joshuawboone/barkitup/README.md

# barkitup
Bark It Up! Fursuits and Rave Gear - ZettaLights dev repo  

LICENSING  
  
All board ref designs follow the same Creative Commons Attribution-ShareAlike 3.0 Unported licensing as the reference boards and stored in the PCB directory directly.  
  
All Code throughout the repo follows the license located at /zettalights/Code/ even if not in this directory. MIT Licensing.  
  
All other designs, STLs, SCAD, and anything else not licensed by the above 2 licenses follows CC BY-NC-SA 4.0 stored at /zettalights/archive/ as well as the respective sub-directories for each project.  
  
Contact support@barkitup.dog for commercial licensing inquiries.  

# You can help support me at https://ko-fi.com/barkitup  

# <3  
# -Z
