joshuawboone/barkitup/zettalights/readme.md

ZettaLights - PCB repo and designs
Bootloader file for PCB and notes on uploading files.

# You can help support me at https://ko-fi.com/barkitup 

# <3
# -Z

Custom wearable Rave Gear.
https://bsky.app/profile/barkitup.dog/post/3lxjax64se22s

https://bsky.app/profile/barkitup.dog/post/3lxr5w2wdyk2l

https://bsky.app/profile/barkitup.dog/post/3lxjed3b53s2s





Based on Adafruit Gemma M0, MAX4466, and Micro-Lipo USB-C designs
Copyright (c) 2017 Adafruit Industries
https://github.com/adafruit/Adafruit-Gemma-M0-PCB
https://github.com/adafruit/Adafruit-MAX4466-Electret-Mic-Amplifier-PCBs
https://github.com/adafruit/Adafruit-MicroLipo-PCB

Modifications Copyright (c) 2025 Joshua (Zettabit Fox) Boone 

LICENSING
All board ref designs follow the same Creative Commons Attribution-ShareAlike 3.0 Unported licensing as the reference boards. 

All Code throughout the repo follows the license located at /zettalights/Code/ even if not in this directory. MIT Licensing.  

All other designs, STLs, SCAD, and anything else not licensed by the above 2 licenses follows CC BY-NC-SA 4.0 stored at /zettalights/archive/ as well as the respective sub-directories for each project. 

Contact support@barkitup.dog for commercial licensing inquiries.
