joshuawboone/barkitup/zettalights/Code/readme.txt

# This is the core directory for the code releases. 

# Note the file name will have the number of LEDs in the series runs. 
# Note some code may be leftover or redundant from the AVR -> ARM conversion process. 
# I'll probably clean it up eventually ... ;3c

# See code directly for comments and user editable variables. 

# You can help support me at https://ko-fi.com/barkitup 

# Code is released under MIT licensing. 

# <3
# -Z
