joshuawboone/barkitup/zettalights/bootloader/readme.txt

# Bootloader v0.1 contains generic USB VID/PID while attempting to get assigned PID. 
# Bootloader v1_2505 contains USB VID/PID for requested 2505 PID on 1209 VID via pid.codes. 

# Build of bootloader was accomplished with the uf2-samdx1 repo and WSL on Windows 11. https://github.com/microsoft/uf2-samdx1.

# Programming of the bootloader was accoplished via OpenOCD and a STM32 ST-Link programmer using PowerShell and Putty.

# Bootloader notes: 
# Modified for SAMD21x17 lower memory map. 

# Command Notes: 

# C:\openocd\OpenOCD-20250710-0.12.0\bin\openocd.exe -f C:\openocd\OpenOCD-20250710-0.12.0\share\openocd\scripts\board\samd21.cfg
# PUTTY > localhost:4444
# halt
# flash write_image erase C:\\openocd\\bootloader-zlcustom-v1_2505.bin 0x0000

# Double tap reset button > should show ZETTALIGHTS USB disk for UF2 uploads. 

# Arduino IDE notes:

# Getting the board definition working involved modifications to the existing Adafruit board definitions by adding a custom board. 

# Included full modified boards.txt and required variant folder(s) to select the board in Arduino IDE. %localappdata%\Arduino15\packages\adafruit\hardware\samd\1.7.16\

# Currently only supports UF2 upload. Export Sketch to BIN, convert to UF2 via python script, drag and drop to board in bootloader mode. 
# python uf2conv.py -c -f 0x68ed2b88 -b 0x2000 sketch_sep7a.ino.bin -o test2.uf2

# Testing to get the board supported directly in IDE requires modifications to the base BOSSAC version and ran into numerous issues. Still testing.
