joshuawboone/barkitup/zettalights/ZL_C-TH_v1/readme.md

PCB designed via EasyEDA. 

Export files are in the EasyEDA .epro format. 

Gerber, BOM, and Pick-and-place files are standard format for use at any manufacturer. 
