joshuawboone/barkitup/zettalights/ZL_C-TH_v1/Enclosure/readme.txt

# Enclosure 3D files. requires 2x lids, 1x box, and 1x switch thing if desired.
