joshuawboone/barkitup/zettalights/Saber/photos/photo_8_2026-06-17_00-31-32.jpg

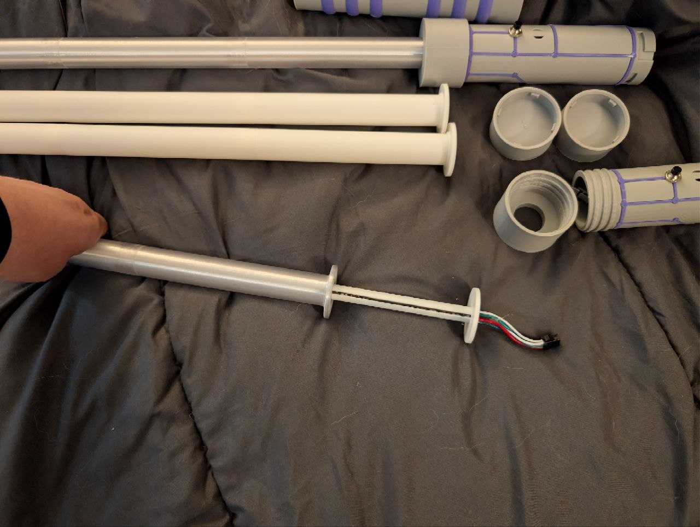
zettalights/Saber/photos/photo_8_2026-06-17_00-31-32.jpg
