joshuawboone/barkitup/zettalights/ZL_C-TH_v1/BOM_ZL_C-TH_v1.xlsx

No. | Quantity | Comment | Designator | Footprint | Value | Manufacturer Part | Manufacturer | Supplier Part | Supplier
1 | 1 | BH-18650-1 | BT1 | BAT-TH_BH-18650-A1AJ005 |  | BH-18650-1 | HanElectricity(瀚源) | C49118395 | LCSC
2 | 5 | 10uF | C1,C5,C6,C7,C8 | C0805 | 10uF | CL21A106KOQNNNE | SAMSUNG(三星) | C1713 | LCSC
3 | 1 | 100nF | C2 | C0603 | 100nF | CC0603KRX7R9BB104 | YAGEO(国巨) | C14663 | LCSC
4 | 1 | 10nF | C3 | C0603 | 10nF | CL10B103KB8NNNC | SAMSUNG(三星) | C1589 | LCSC
5 | 1 | 100pF | C4 | C0603 | 100pF | CL10C101JB8NNNC | SAMSUNG(三星) | C14858 | LCSC
6 | 1 | 1uF | C9 | C0805 | 1uF | 0805B105K500NT | FH(风华) | C215803 | LCSC
7 | 1 | 1uF | C10 | C0603 | 1uF | CL10A105KB8NNNC | SAMSUNG(三星) | C15849 | LCSC
8 | 2 | SS54 | D1,D2 | SMA_L4.4-W2.8-LS5.4-R-RD |  | SS54 | MDD(辰达半导体) | C22452 | LCSC
9 | 2 | SWD1 | GND,SWD | CON_PAD_ROUND_1.02MM
10 | 1 | 2-Pin | JP2 | HDR-TH_2P-P2.54-V-M-2
11 | 1 | 3-Pin | JP3 | HDR-TH_3P-P2.54-V-F_MF254V-11-03-0743
12 | 2 | BLM21PG221SN1D | L1,L2 | L0805 |  | BLM21PG221SN1D | muRata(村田) | C85840 | LCSC
13 | 1 | CHG Orange | LED1 | LED0805-RD_ORANGE |  | NCD0805O1 | 国星光电 | C84262 | LCSC
14 | 1 | PWR Red | LED2 | LED0805-R-RD |  | NCD0805R1 | 国星光电 | C84256 | LCSC
15 | 1 | CHGD Green | LED3 | LED0805-R-RD |  | NCD0805G1 | 国星光电 | C84260 | LCSC
16 | 1 | GMI9767P-60DB | MIC1 | MIC-TH_BD9.7-P2.54-D0.8-L-FD |  | GMI9767P-60DB | INGHAi(赢海) | C234027 | LCSC
17 | 1 | 100kΩ | R1 | RES-ADJ-SMD_3P-L4.5-W4.5-P2.30-BL-FS | 100kΩ | 3314J-1-104E | BOURNS | C51284 | LCSC
18 | 2 | 470Ω | R2,R3 | R0603 | 470Ω | 0603WAF4700T5E | UNI-ROYAL(厚声) | C23179 | LCSC
19 | 5 | 1kΩ | R4,R5,R6,R7,R8 | R0603 | 1kΩ | 0603WAF1001T5E | UNI-ROYAL(厚声) | C21190 | LCSC
20 | 2 | 1MΩ | R9,R10 | R0402 | 1MΩ | 0402WGF1004TCE | UNI-ROYAL(厚声) | C26083 | LCSC
21 | 1 | 22kΩ | R11 | R0402 | 22kΩ | 0402WGF2202TCE | UNI-ROYAL(厚声) | C25768 | LCSC
22 | 2 | 5.1kΩ | R12,R13 | R0603 | 5.1kΩ | 0603WAF5101T5E | UNI-ROYAL(厚声) | C23186 | LCSC
23 | 1 | TP1 | RST | CON_PAD_ROUND_1.02MM
24 | 1 | RST | SW1 | SW-SMD_L3.9-W3.0-P4.45 |  | TS-1088-AR02016 | XUNPU(讯普) | C720477 | LCSC
25 | 1 | SWC1 | SWC | CON_PAD_ROUND_1.02MM
26 | 1 | ATSAMD21E17A-AU | U1 | TQFP-32_L7.0-W7.0-P0.80-LS9.0-BL |  | ATSAMD21E17A-AU | MICROCHIP(美国微芯) | C1337408 | LCSC
27 | 1 | MAX4466EXK+T | U2 | SC-70-5_L2.0-W1.3-P0.65-LS2.1-BR |  | MAX4466EXK+T | ADI(亚德诺)/MAXIM(美信) | C7456762 | LCSC
28 | 1 | MCP73831T-2ACI/OT | U3 | SOT-23-5_L3.0-W1.7-P0.95-LS2.8-BL |  | MCP73831T-2ACI/OT | MICROCHIP(美国微芯) | C424093 | LCSC
29 | 1 | AP2112K-3.3TRG1 | U4 | SOT-25-5_L2.9-W1.6-P0.95-LS2.8-BL |  | AP2112K-3.3TRG1 | DIODES(美台) | C51118 | LCSC
30 | 1 | SW Power | U5 | SW-TH_SS-12M12G5 |  | SS-12M12G5 | XKB Connectivity(中国星坤) | C2884789 | LCSC
31 | 1 | USB4085-GF-A | USB2 | USC-C-SMD_USB4085-GF-A |  | USB4085-GF-A | GCT | C7095263 | LCSC
