joshuawboone/barkitup/zettalights/Saber/320-Saber-Full-Project.3mf

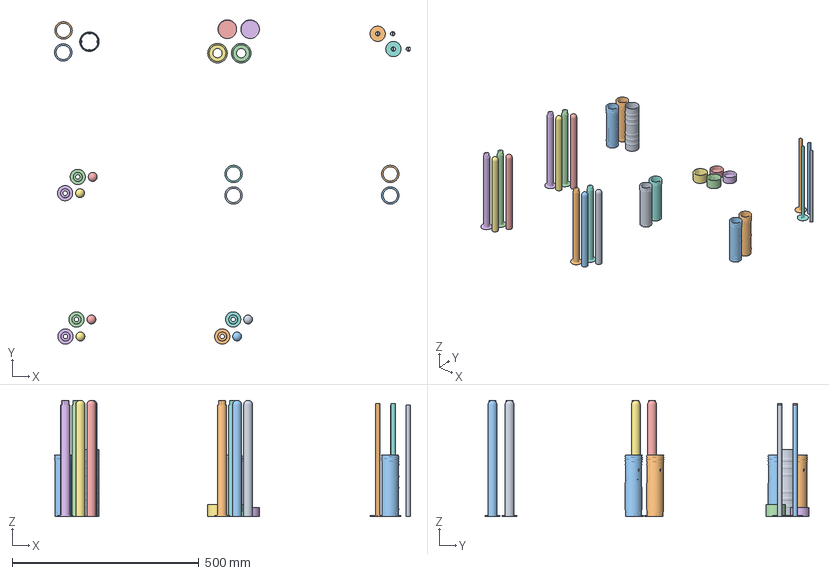
[picture p19: CAD file, 2026-08-04]
zettalights/Saber/320-Saber-Full-Project.3mf
954.1 x 869.1 x 312.0 mm
Coupler-plain
Handle-plain x 2
Cap-bladeSide.stl x 2
Cap-pommelSide.stl x 2
LED_seg1.stl x 2
LED_seg2.stl x 2
seg1.stl x 6
seg2.stl x 6
Handle-plain.stl x 2
Handle-oneColor.stl x 2
