joshuawboone/barkitup/zettalights/Staff/320/320-Staff-Full-Project.3mf

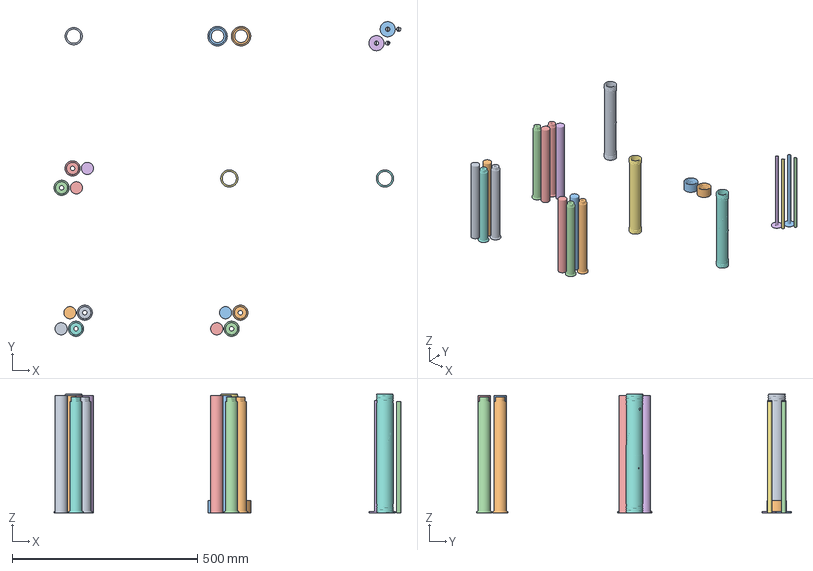
[picture p20: CAD file, 2026-08-04]
zettalights/Staff/320/320-Staff-Full-Project.3mf
936.6 x 849.5 x 320.0 mm
handle_plain
cap.stl x 2
LED-seg1.stl x 2
LED-seg2.stl x 2
seg1.stl x 6
seg2.stl x 6
handle_plain.stl
handle_traces.stl
