joshuawboone/barkitup/zettalights/Saber/Handle/handle-inserts-full.stl

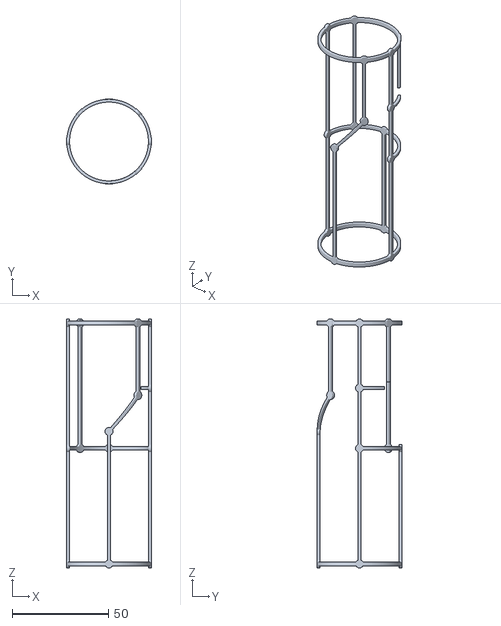
[picture p21: CAD file, 2026-06-17]
zettalights/Saber/Handle/handle-inserts-full.stl
44.2 x 44.2 x 129.6
