joshuawboone/barkitup/zettalights/Saber/v2_2-Full.3mf

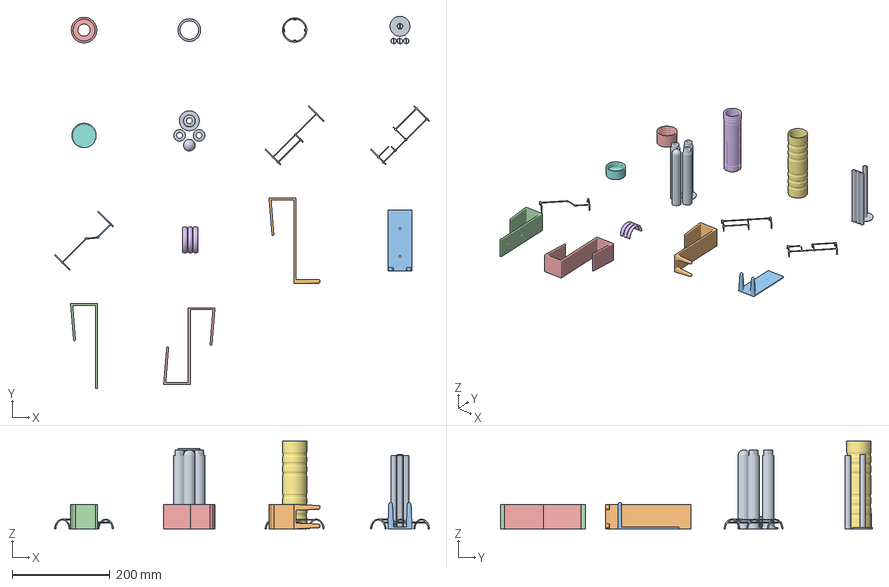
[picture p22: CAD file, 2026-06-17]
zettalights/Saber/v2_2-Full.3mf
769.2 x 763.8 x 180.0 mm
Assembly x 3
handle-insert-1.stl
handle-insert-3.stl
handle-insert-2.stl
open cap.stl
handle.stl
coupler.stl
closed cap.stl
saber_hanger.stl
saber_wall_fork.stl
saber_wall_hanger.stl
saber_doubleHook.stl
