joshuawboone/barkitup/zettalights/Saber/320/seg2.stl

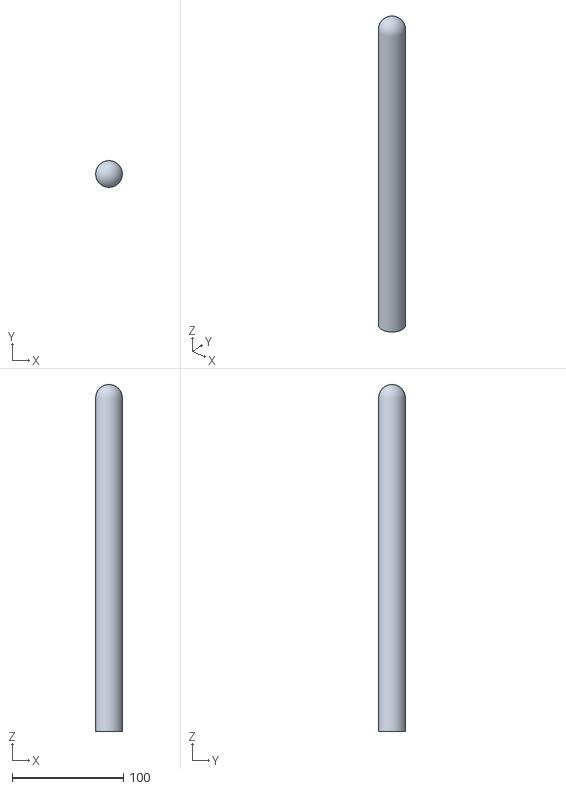
[picture p23: CAD file, 2026-08-04]
zettalights/Saber/320/seg2.stl
24.0 x 24.0 x 312.0
