joshuawboone/barkitup/zettalights/Saber/Blade/blade tip.stl

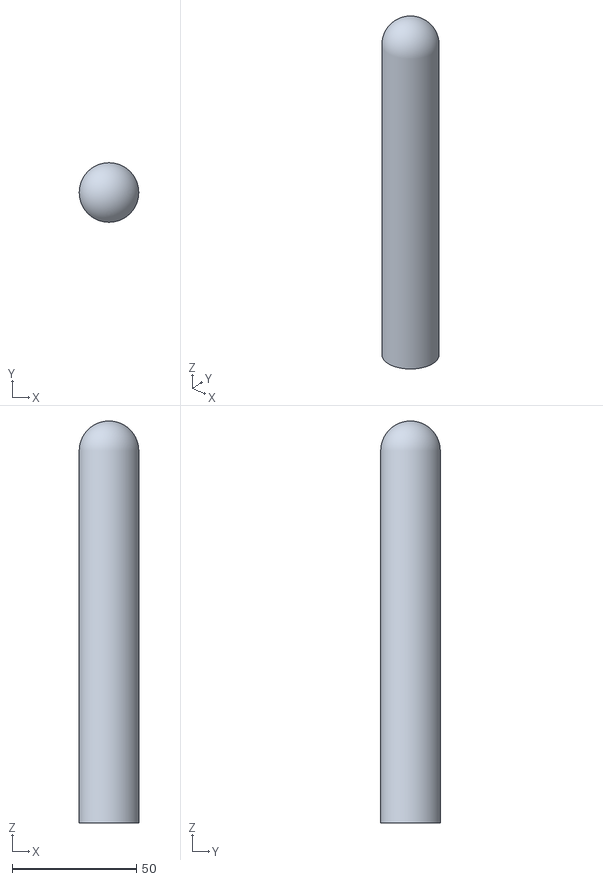
[picture p24: CAD file, 2026-06-17]
zettalights/Saber/Blade/blade tip.stl
24.0 x 24.0 x 162.0
