joshuawboone/barkitup/zettalights/Saber/Coupler-rings.stl

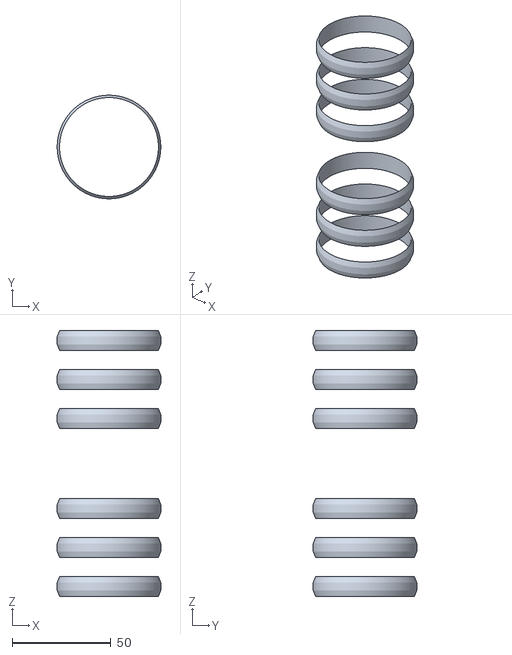
[picture p25: CAD file, 2026-08-04]
zettalights/Saber/Coupler-rings.stl
52.4 x 52.4 x 134.5
