joshuawboone/barkitup/zettalights/Saber/Handle/handle.stl

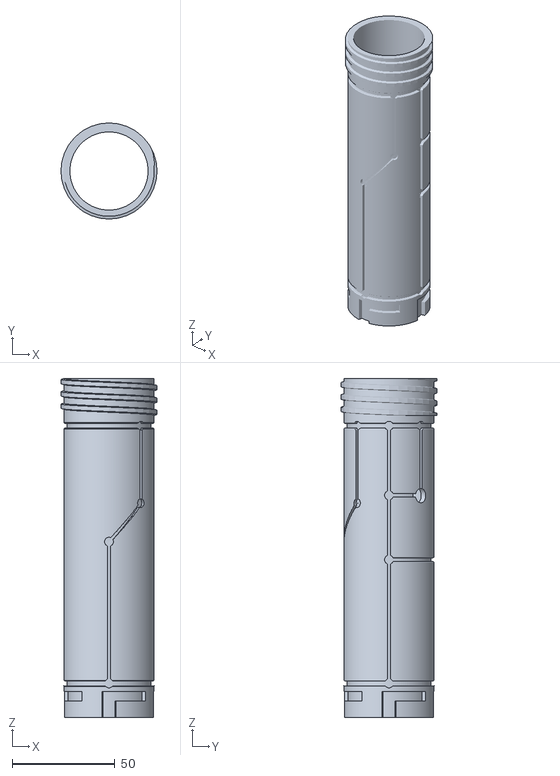
[picture p26: CAD file, 2026-06-17]
zettalights/Saber/Handle/handle.stl
46.8 x 46.8 x 165.0
