joshuawboone/barkitup/zettalights/Saber/Hangers/saber_hanger.stl

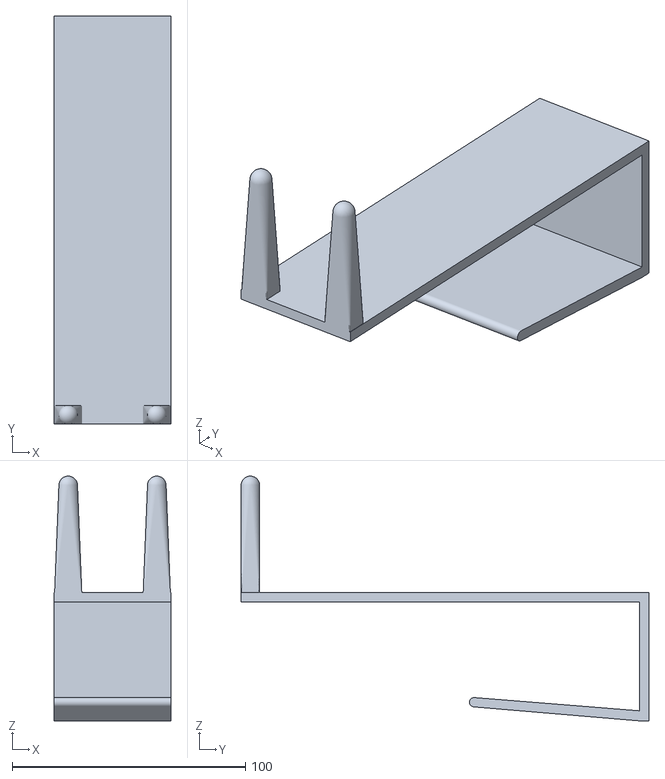
[picture p27: CAD file, 2026-06-17]
zettalights/Saber/Hangers/saber_hanger.stl
50.0 x 175.0 x 105.0
