joshuawboone/barkitup/zettalights/Staff/256/LEDinsert2-3.stl

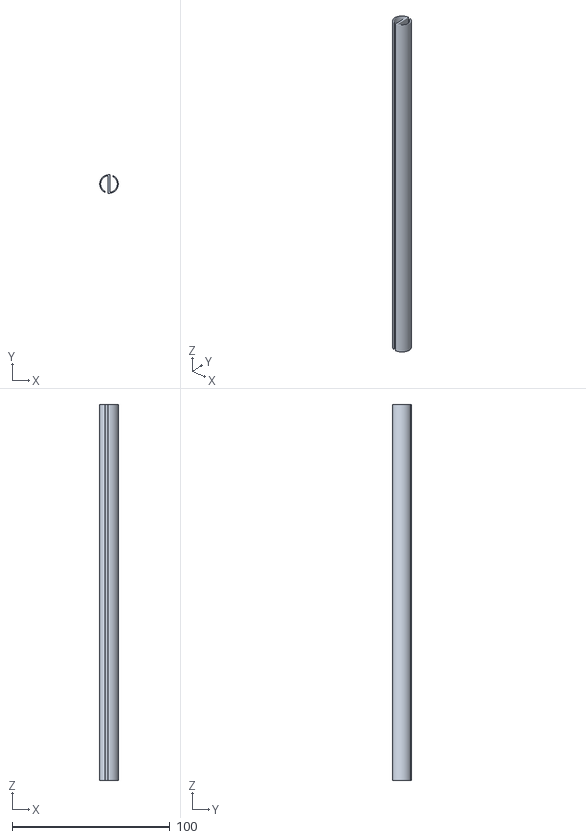
[picture p28: CAD file, 2026-07-16]
zettalights/Staff/256/LEDinsert2-3.stl
11.8 x 11.8 x 238.0
