joshuawboone/barkitup/zettalights/Staff/320/new_cap.stl

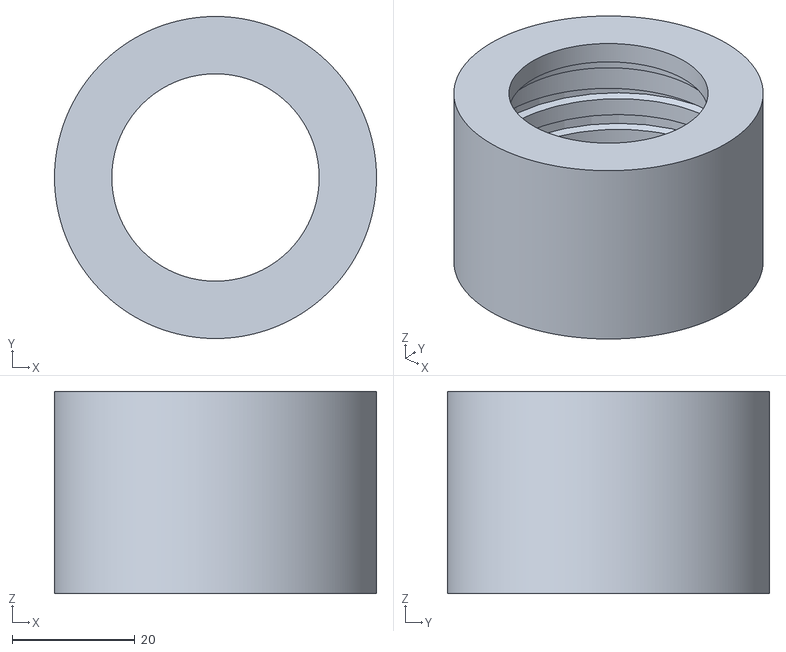
[picture p29: CAD file, 2026-10-22]
zettalights/Staff/320/new_cap.stl
52.5 x 52.5 x 33.0
