joshuawboone/barkitup/zettalights/Staff/340/LEDseg2.stl

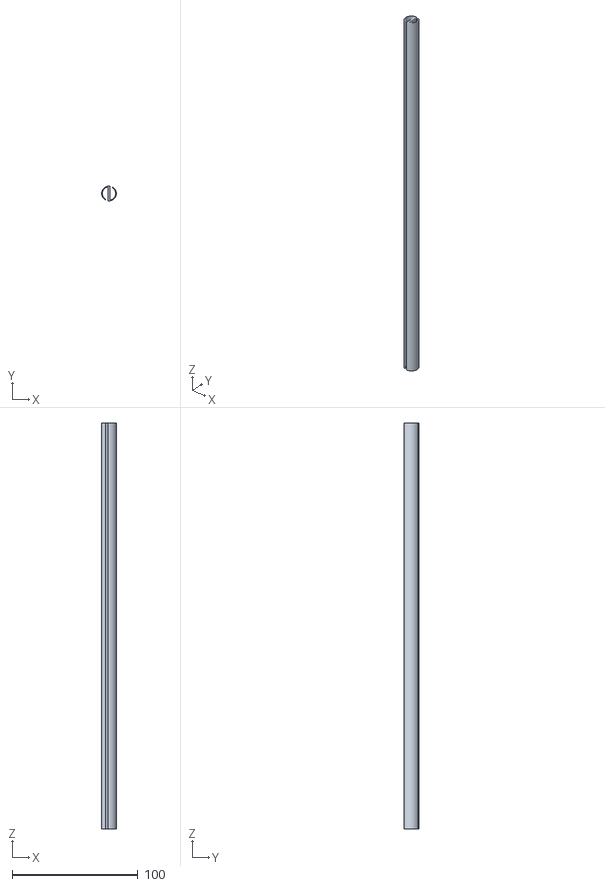
[picture p30: CAD file, 2026-07-16]
zettalights/Staff/340/LEDseg2.stl
11.8 x 11.8 x 323.0
