joshuawboone/barkitup/zettalights/Staff/seg1.stl

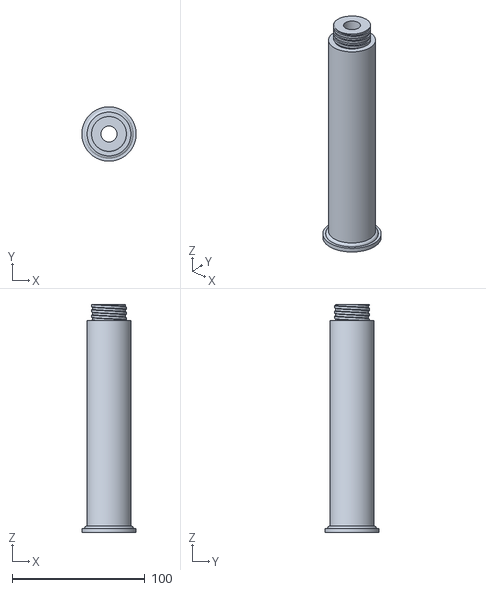
[picture p31: CAD file, 2026-07-16]
zettalights/Staff/seg1.stl
41.0 x 41.0 x 172.0
