joshuawboone/barkitup/zettalights/ZL_C-TH_v1/Enclosure/Lid-v4-testtabs.stl

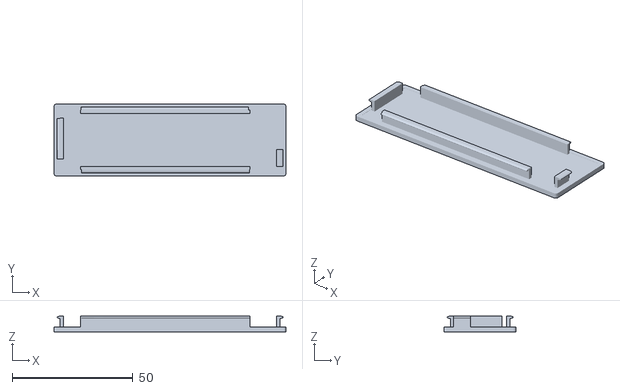
[picture p32: CAD file, 2025-10-22]
zettalights/ZL_C-TH_v1/Enclosure/Lid-v4-testtabs.stl
95.9 x 29.7 x 6.50
