joshuawboone/barkitup/zettalights/Saber/320/LED_seg1.stl

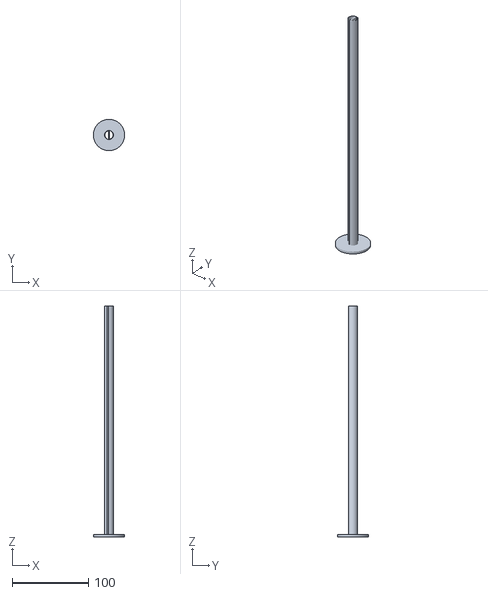
[picture p33: CAD file, 2026-08-04]
zettalights/Saber/320/LED_seg1.stl
41.0 x 41.0 x 303.0
