joshuawboone/barkitup/zettalights/Saber/Blade/blade base.stl

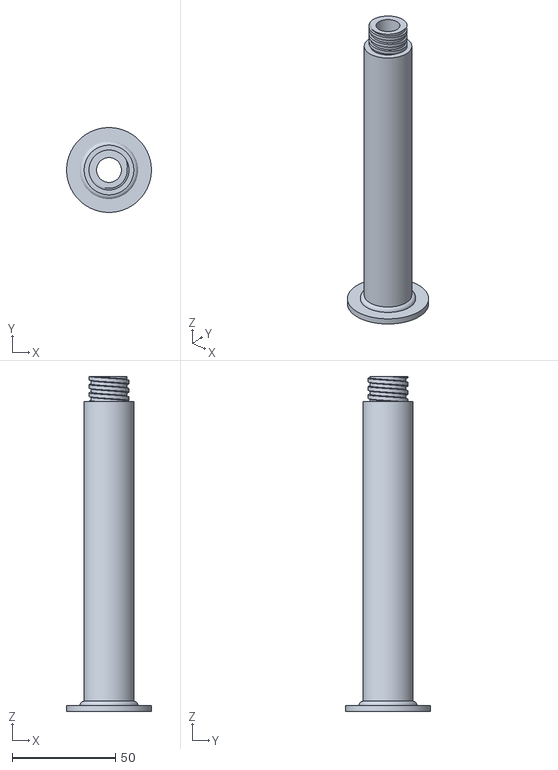
[picture p34: CAD file, 2026-06-17]
zettalights/Saber/Blade/blade base.stl
41.0 x 41.0 x 162.0
