joshuawboone/barkitup/zettalights/Saber/Cap-pommelSide.stl

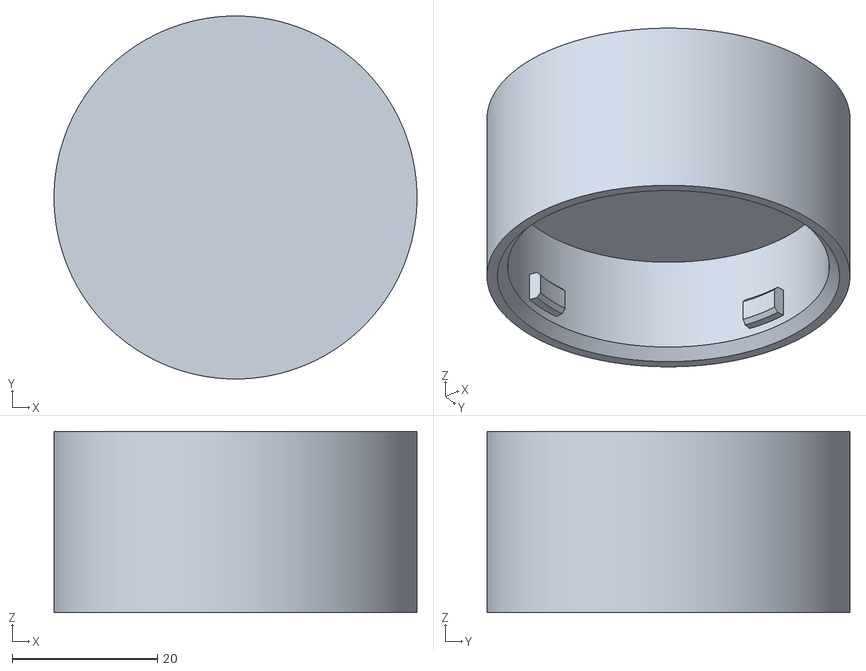
[picture p35: CAD file, 2026-08-04]
zettalights/Saber/Cap-pommelSide.stl
50.0 x 50.0 x 25.0
