joshuawboone/barkitup/zettalights/Saber/Handle/coupler.stl

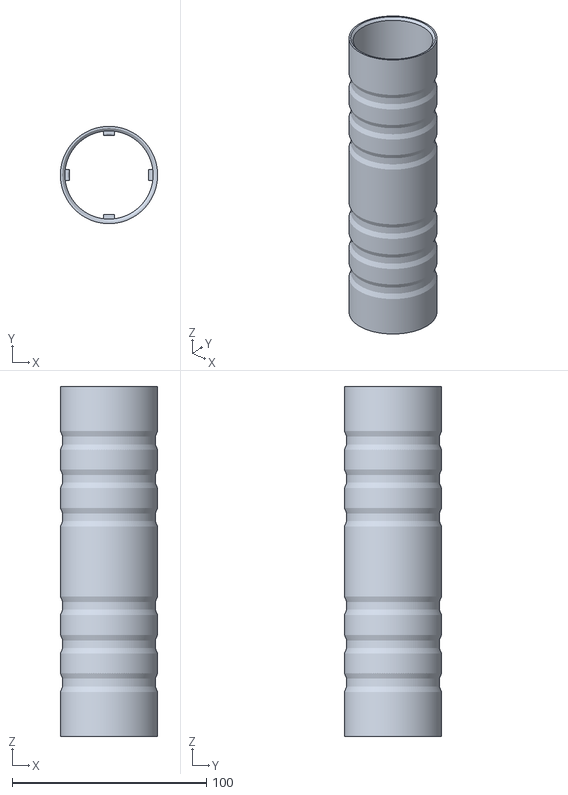
[picture p36: CAD file, 2026-06-17]
zettalights/Saber/Handle/coupler.stl
50.0 x 50.0 x 180.0
