joshuawboone/barkitup/zettalights/Saber/Hangers/saber_wall_fork.stl

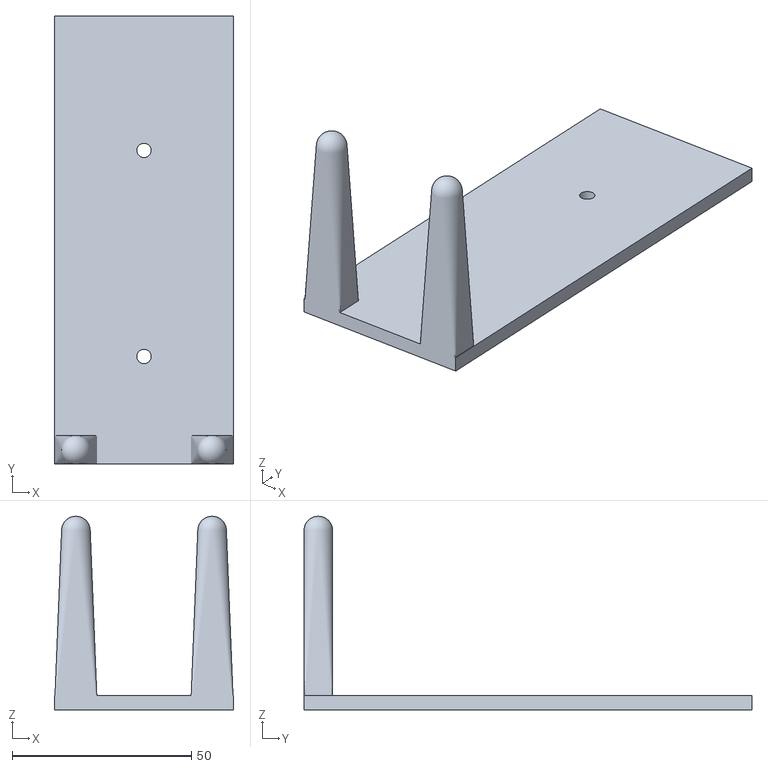
[picture p37: CAD file, 2026-06-17]
zettalights/Saber/Hangers/saber_wall_fork.stl
50.0 x 125.0 x 54.0
