joshuawboone/barkitup/zettalights/Staff/256/seg1.stl

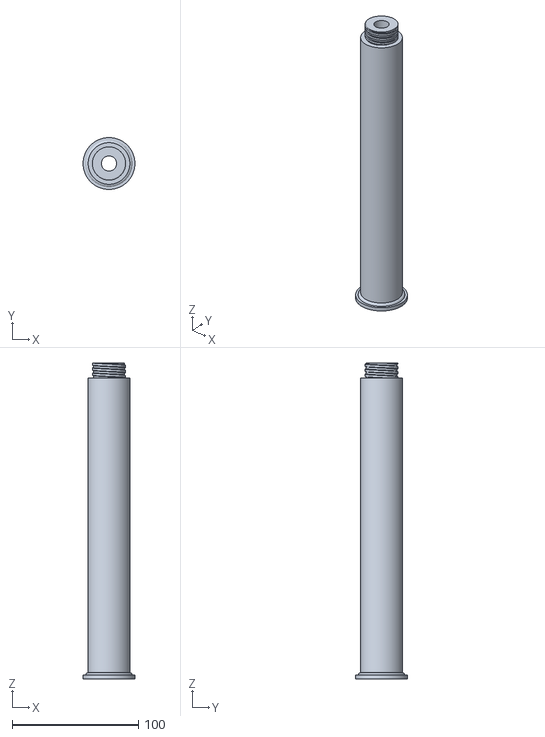
[picture p38: CAD file, 2026-07-16]
zettalights/Staff/256/seg1.stl
41.0 x 41.0 x 250.0
