joshuawboone/barkitup/zettalights/Staff/340/seg1.stl

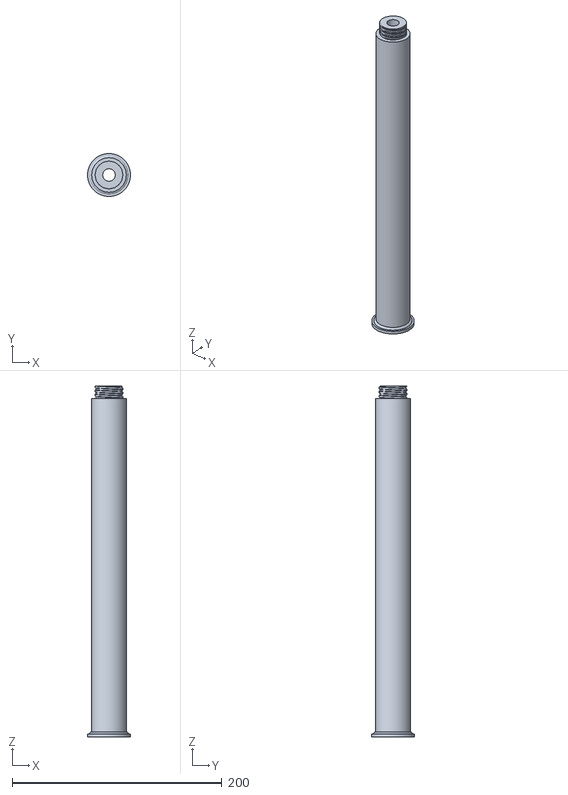
[picture p39: CAD file, 2026-07-16]
zettalights/Staff/340/seg1.stl
41.0 x 41.0 x 335.0
