joshuawboone/barkitup/zettalights/ZL_C-TH_v1/Enclosure/Box-v4-clip.stl

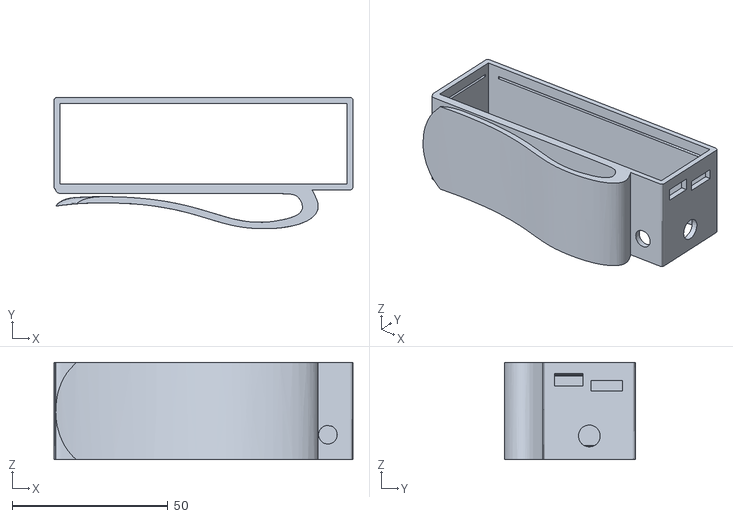
[picture p40: CAD file, 2025-10-22]
zettalights/ZL_C-TH_v1/Enclosure/Box-v4-clip.stl
95.9 x 42.1 x 31.2
