joshuawboone/barkitup/zettalights/Saber/320/seg1.stl

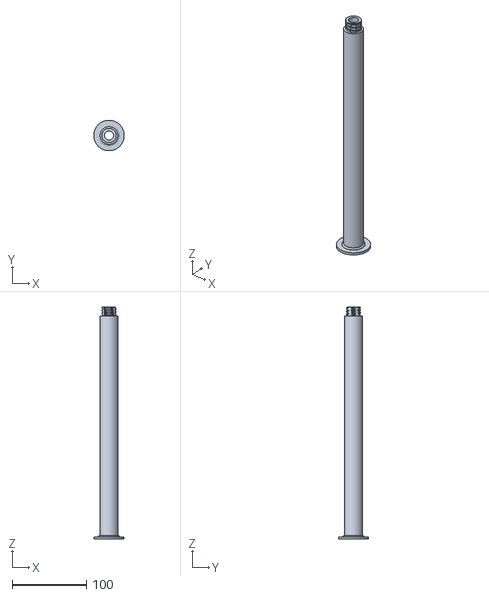
[picture p41: CAD file, 2026-08-04]
zettalights/Saber/320/seg1.stl
41.0 x 41.0 x 312.0
