joshuawboone/barkitup/zettalights/Saber/Coupler-oneColor.stl

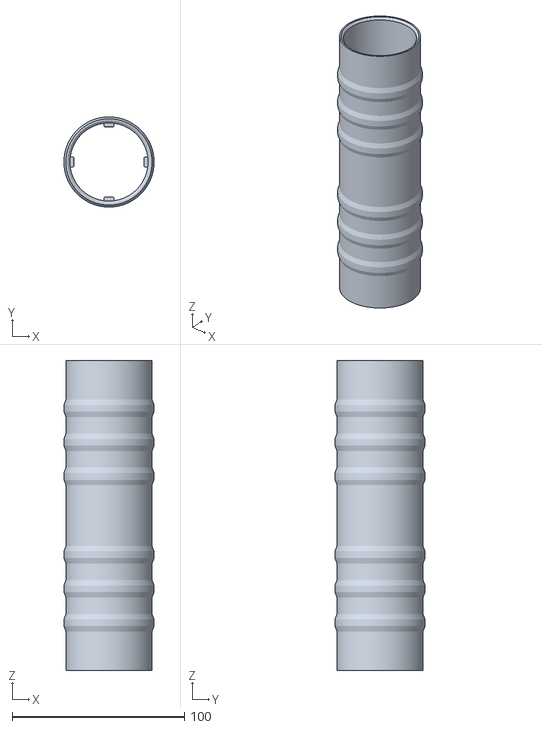
[picture p42: CAD file, 2026-08-04]
zettalights/Saber/Coupler-oneColor.stl
52.4 x 52.4 x 180.0
