joshuawboone/barkitup/zettalights/Saber/Handle/open cap.stl

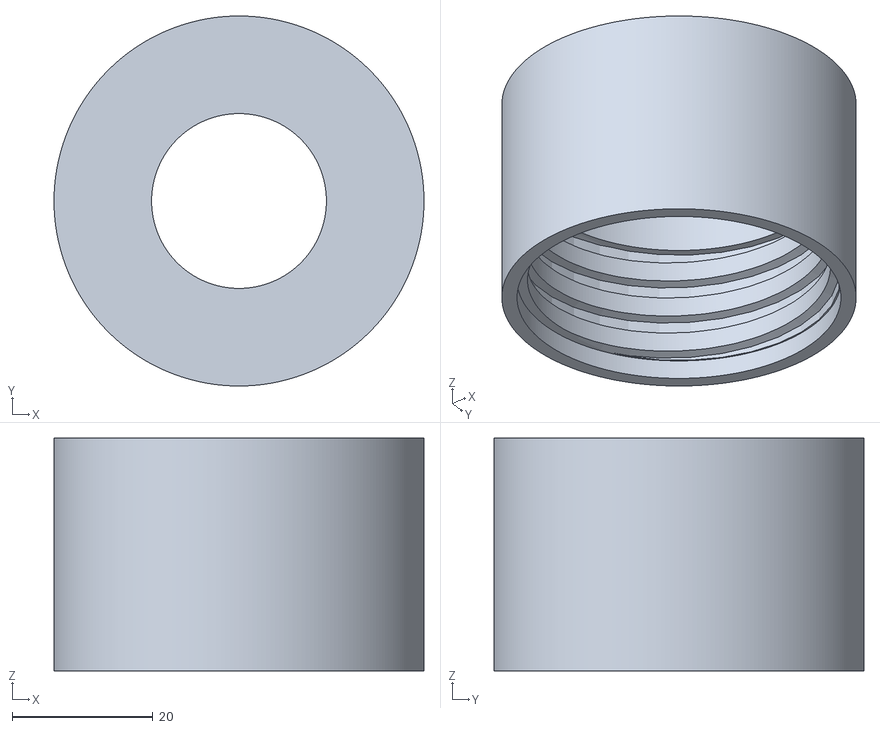
[picture p43: CAD file, 2026-06-17]
zettalights/Saber/Handle/open cap.stl
52.5 x 52.5 x 33.0
