joshuawboone/barkitup/zettalights/Saber/Hangers/wall-fork.stl

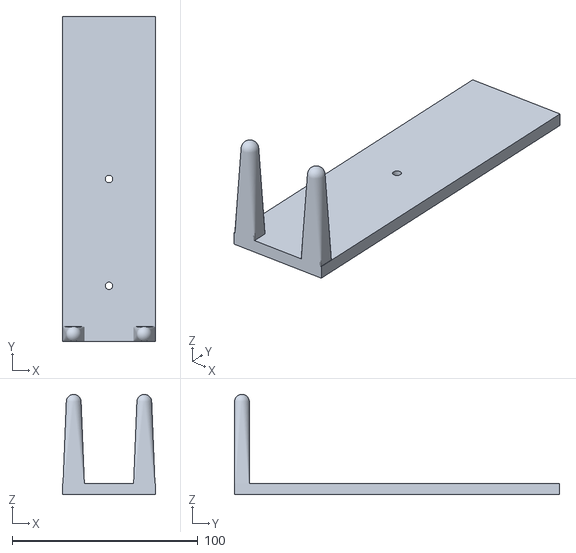
[picture p44: CAD file, 2026-06-17]
zettalights/Saber/Hangers/wall-fork.stl
50.0 x 175.0 x 54.0
