joshuawboone/barkitup/zettalights/Staff/256/LEDinsert1.stl

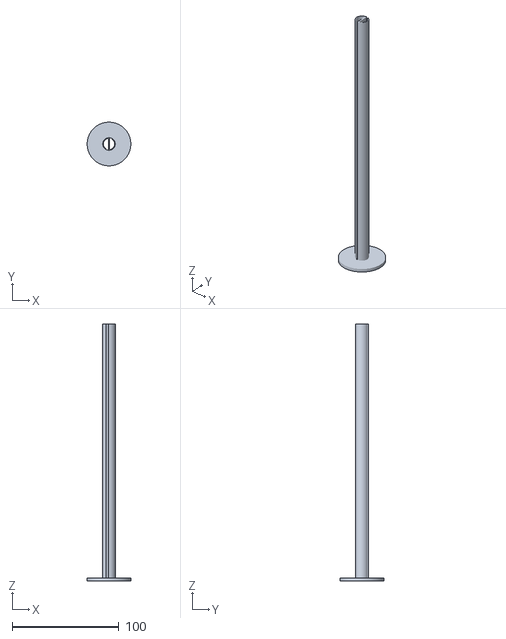
[picture p45: CAD file, 2026-07-16]
zettalights/Staff/256/LEDinsert1.stl
41.0 x 41.0 x 241.0
