joshuawboone/barkitup/zettalights/Staff/320/handle_traces.stl

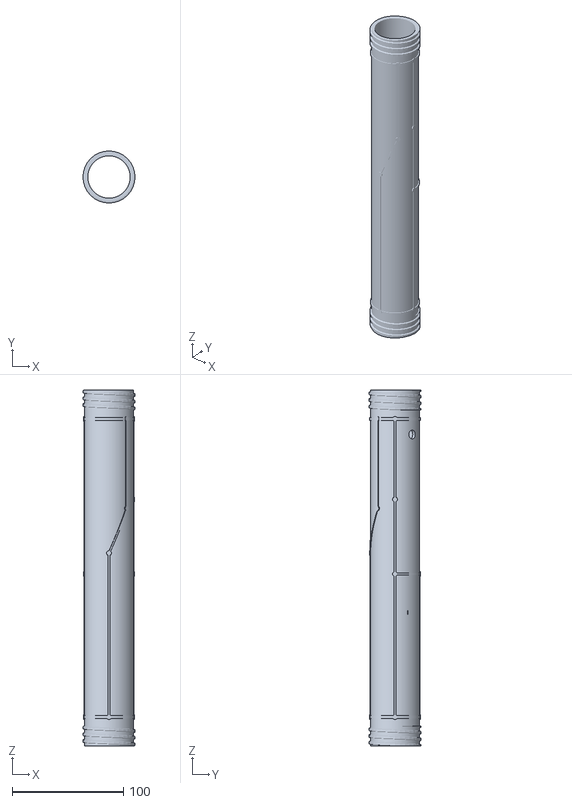
[picture p46: CAD file, 2026-08-04]
zettalights/Staff/320/handle_traces.stl
46.8 x 46.8 x 320.0
