joshuawboone/barkitup/zettalights/Staff/handle256.stl

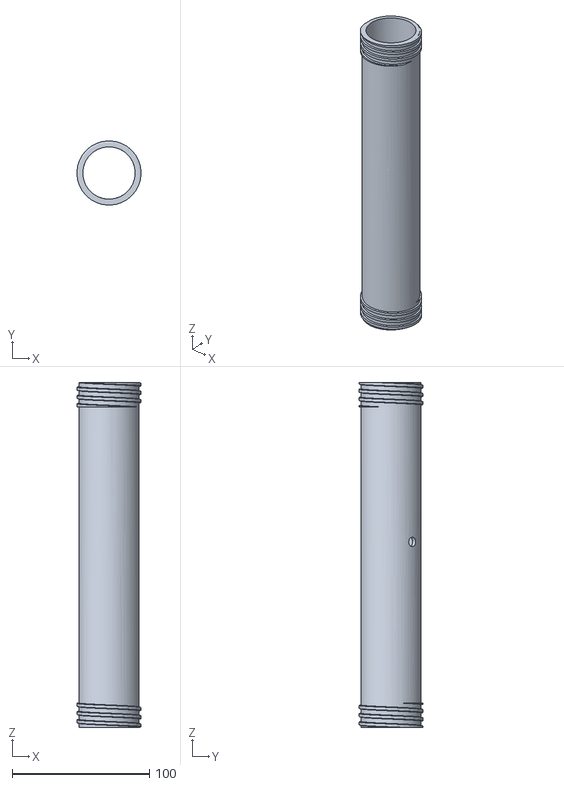
[picture p47: CAD file, 2026-07-16]
zettalights/Staff/handle256.stl
46.8 x 46.8 x 251.0
