joshuawboone/barkitup/zettalights/ZL_C-TH_v1/Enclosure/ButtonThing-v4.stl

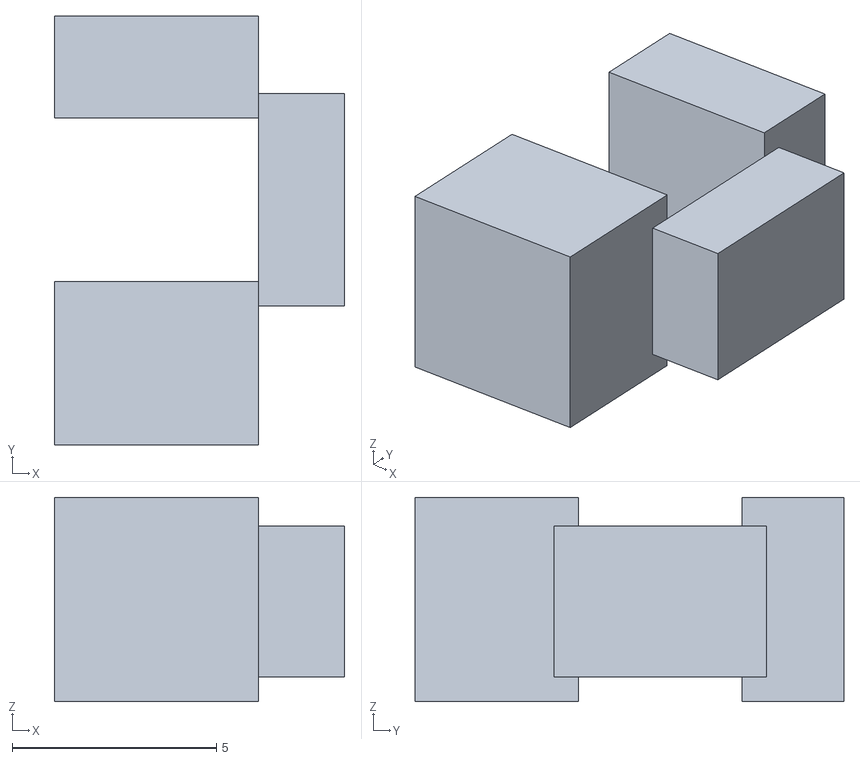
[picture p48: CAD file, 2025-10-22]
zettalights/ZL_C-TH_v1/Enclosure/ButtonThing-v4.stl
7.10 x 10.5 x 5.00
