joshuawboone/barkitup/zettalights/Saber/320/LED_seg2.stl

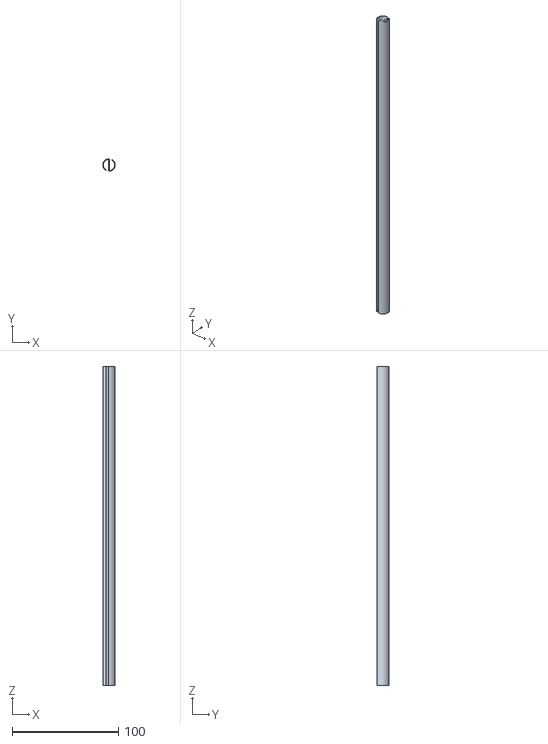
[picture p49: CAD file, 2026-07-16]
zettalights/Saber/320/LED_seg2.stl
11.8 x 11.8 x 300.0
