joshuawboone/barkitup/zettalights/Saber/Handle/handle-insert-3.stl

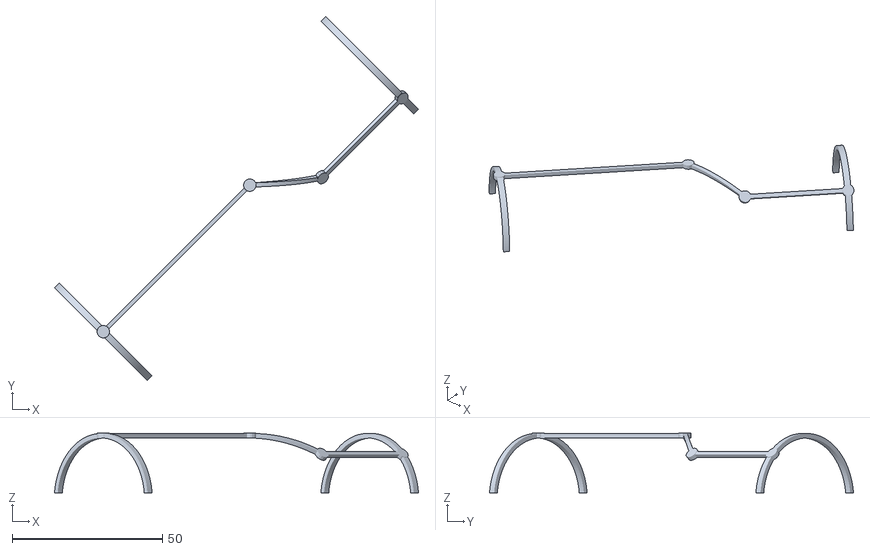
[picture p50: CAD file, 2026-06-17]
zettalights/Saber/Handle/handle-insert-3.stl
121.2 x 121.2 x 19.9
