joshuawboone/barkitup/zettalights/Saber/Hangers/cube-fork.stl

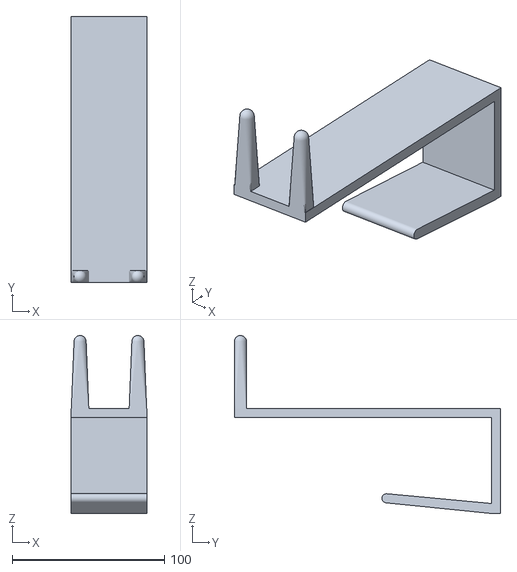
[picture p51: CAD file, 2026-06-17]
zettalights/Saber/Hangers/cube-fork.stl
50.0 x 175.0 x 117.0
