joshuawboone/barkitup/zettalights/Staff/256/seg2.stl

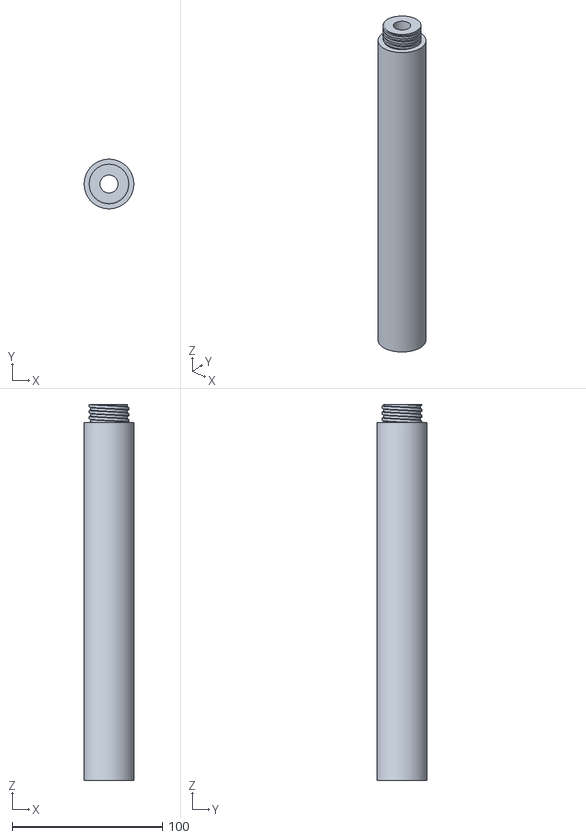
[picture p52: CAD file, 2026-07-16]
zettalights/Staff/256/seg2.stl
33.0 x 33.0 x 250.0
