joshuawboone/barkitup/zettalights/Staff/340/handle340.stl

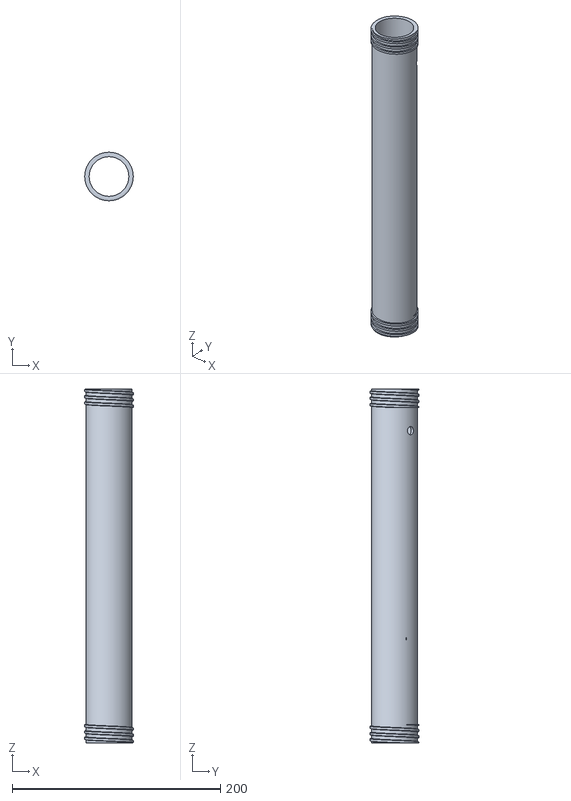
[picture p53: CAD file, 2026-07-16]
zettalights/Staff/340/handle340.stl
46.8 x 46.8 x 340.0
