joshuawboone/barkitup/zettalights/Staff/LED-seg1.stl

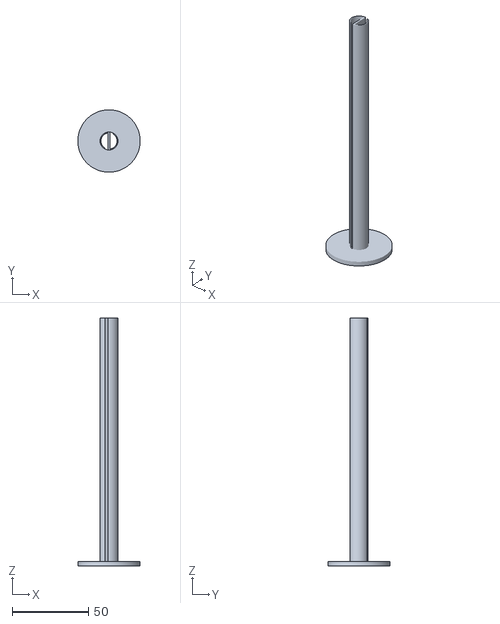
[picture p54: CAD file, 2026-07-16]
zettalights/Staff/LED-seg1.stl
41.0 x 41.0 x 163.0
