joshuawboone/barkitup/zettalights/Saber/Hangers/wall-hook.stl

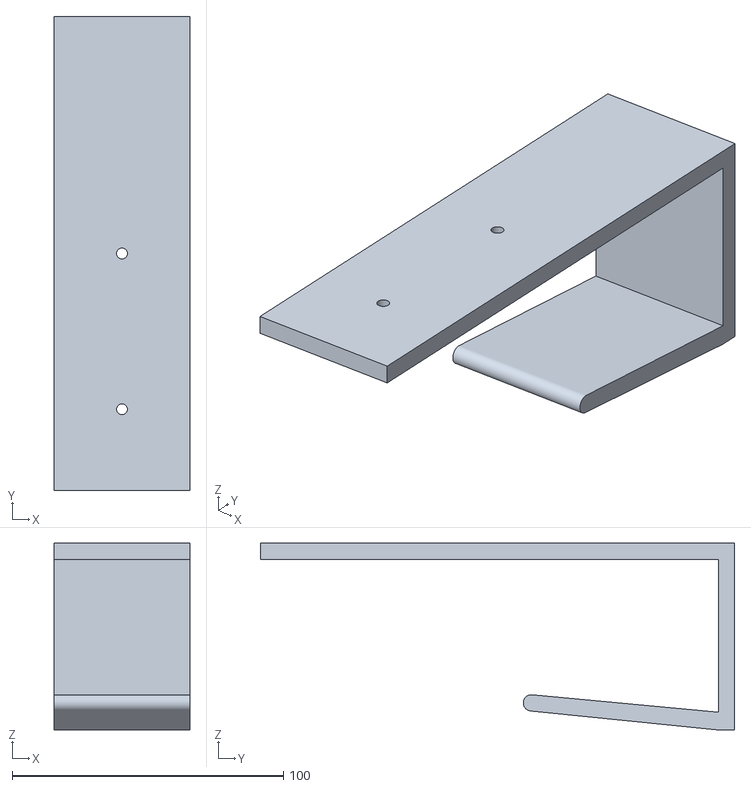
[picture p55: CAD file, 2026-06-17]
zettalights/Saber/Hangers/wall-hook.stl
50.0 x 175.0 x 69.0
