joshuawboone/barkitup/zettalights/Staff/340/LEDseg1.stl

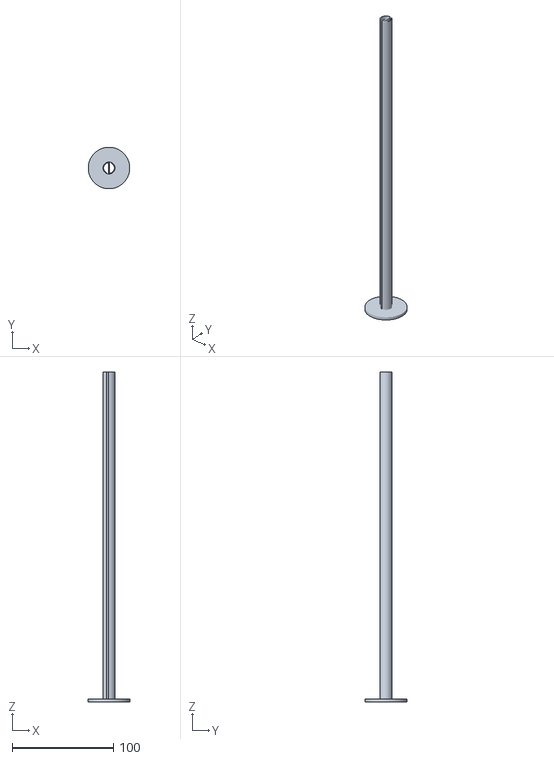
[picture p56: CAD file, 2026-07-16]
zettalights/Staff/340/LEDseg1.stl
41.0 x 41.0 x 326.0
