joshuawboone/barkitup/zettalights/Staff/seg2-3.stl

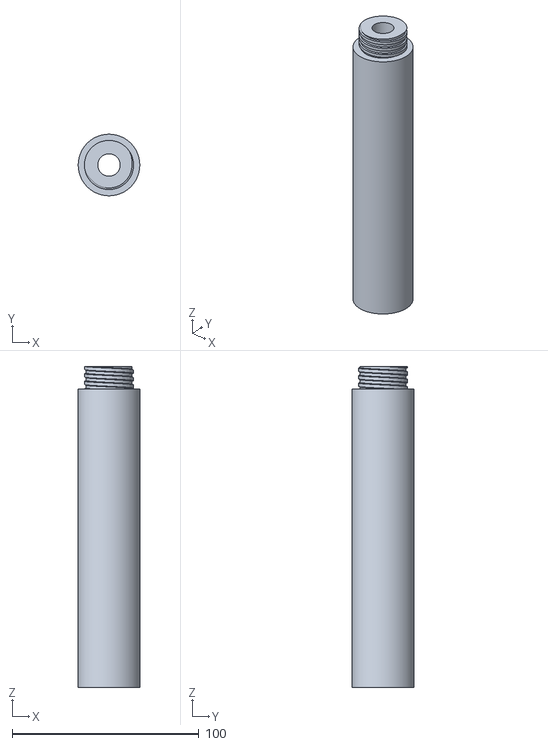
[picture p57: CAD file, 2026-07-16]
zettalights/Staff/seg2-3.stl
33.0 x 33.0 x 172.0
