joshuawboone/barkitup/zettalights/Saber/Blade/LEDseg234.stl

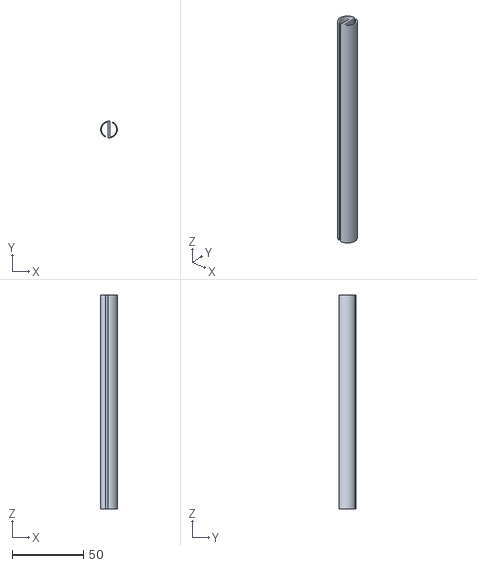
[picture p58: CAD file, 2026-06-17]
zettalights/Saber/Blade/LEDseg234.stl
11.8 x 11.8 x 150.0
