joshuawboone/barkitup/zettalights/Saber/Handle-plain.stl

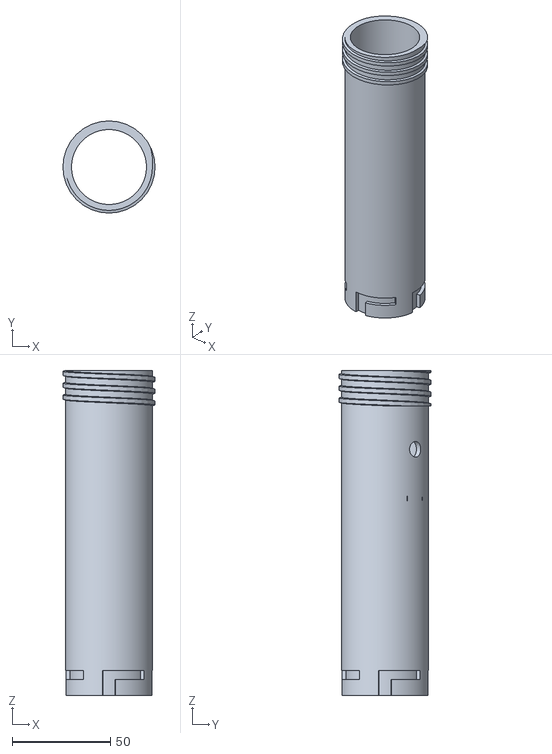
[picture p59: CAD file, 2026-08-04]
zettalights/Saber/Handle-plain.stl
46.8 x 46.8 x 165.0
