joshuawboone/barkitup/zettalights/Saber/Handle/coupler-insert.stl

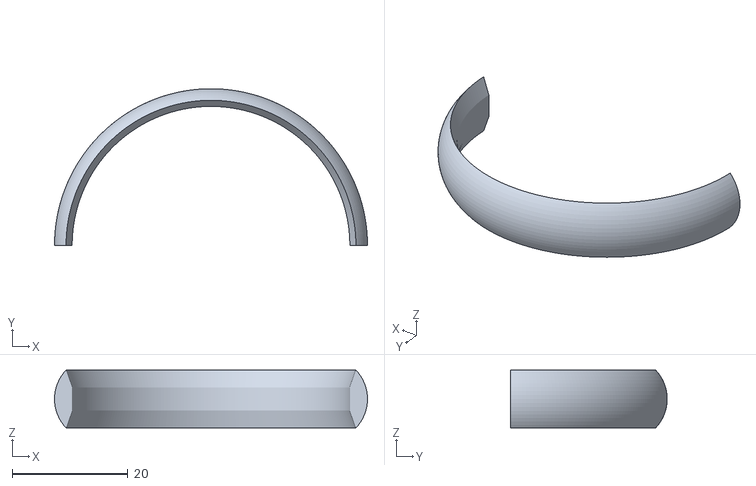
[picture p60: CAD file, 2026-06-17]
zettalights/Saber/Handle/coupler-insert.stl
54.0 x 27.0 x 10.0
