joshuawboone/barkitup/zettalights/Saber/Hangers/saber_wall_hanger.stl

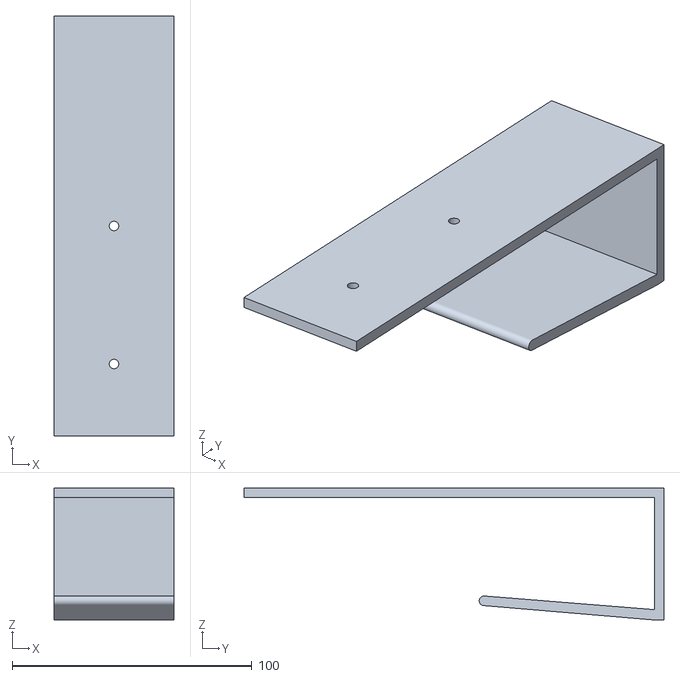
[picture p61: CAD file, 2026-06-17]
zettalights/Saber/Hangers/saber_wall_hanger.stl
50.0 x 175.0 x 55.0
