joshuawboone/barkitup/zettalights/Staff/320/seg1.stl

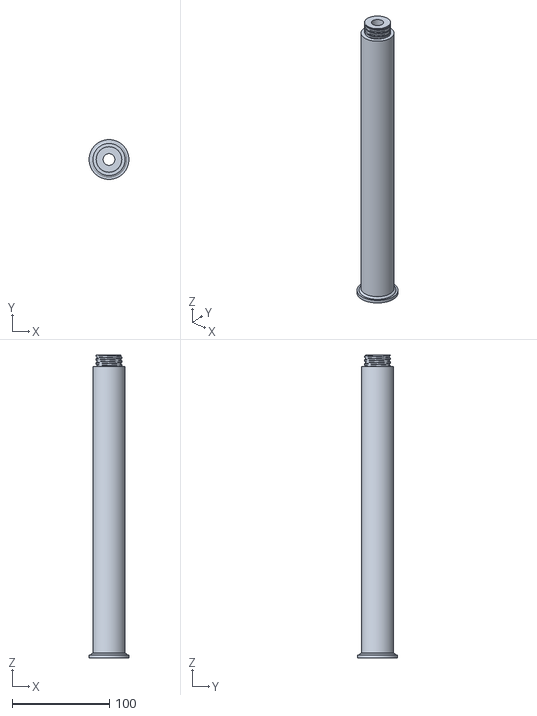
[picture p62: CAD file, 2026-08-04]
zettalights/Staff/320/seg1.stl
41.0 x 41.0 x 312.0
