joshuawboone/barkitup/zettalights/Staff/340/seg2.stl

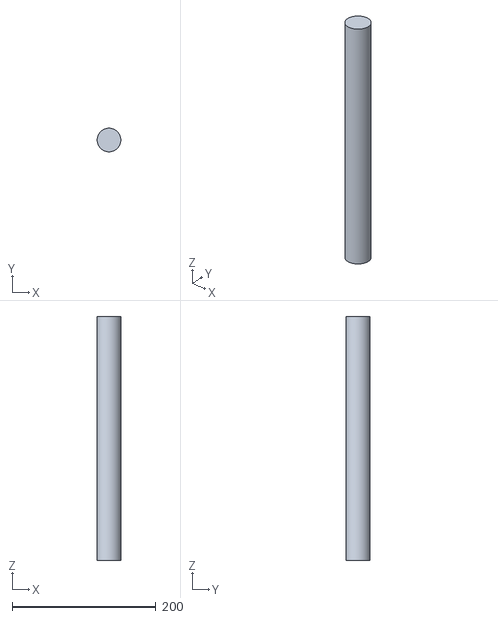
[picture p63: CAD file, 2026-07-16]
zettalights/Staff/340/seg2.stl
33.0 x 33.0 x 339.5
