joshuawboone/barkitup/zettalights/Staff/LED-seg2-3-4.stl

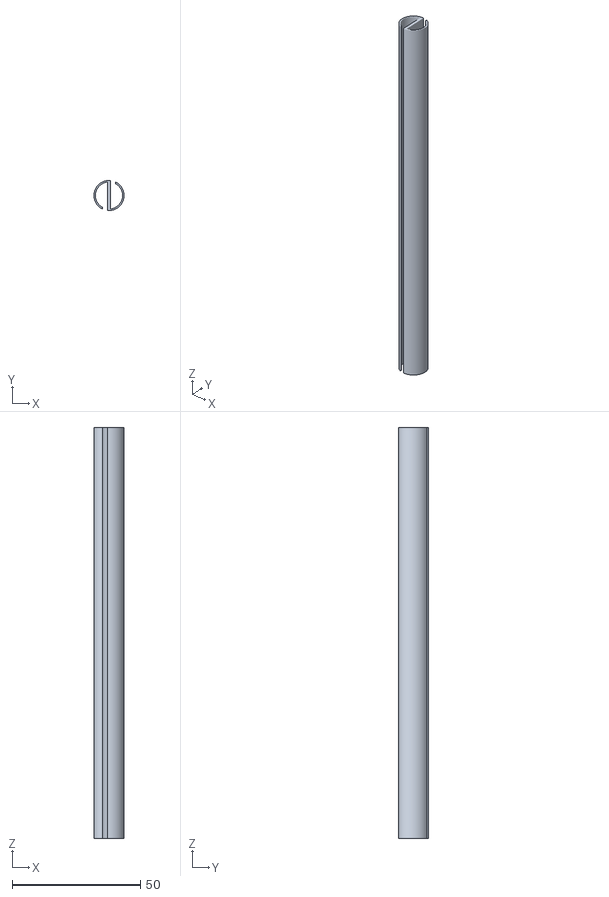
[picture p64: CAD file, 2026-07-16]
zettalights/Staff/LED-seg2-3-4.stl
11.8 x 11.8 x 160.0
