joshuawboone/barkitup/zettalights/Saber/Blade/LEDseg1.stl

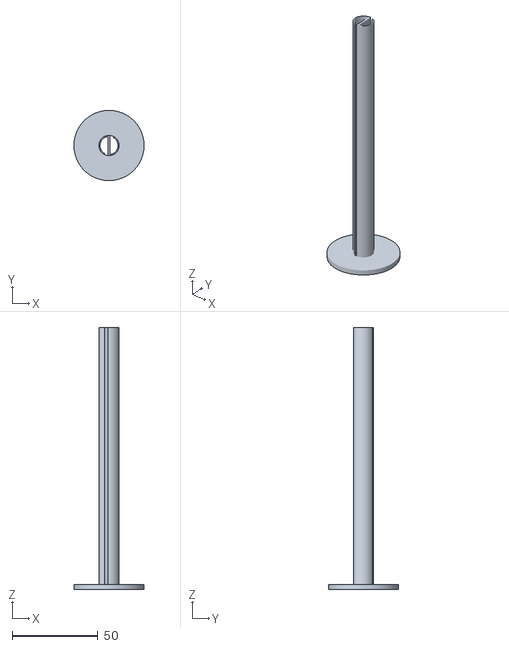
[picture p65: CAD file, 2026-06-17]
zettalights/Saber/Blade/LEDseg1.stl
41.0 x 41.0 x 153.0
