joshuawboone/barkitup/zettalights/Saber/Handle-oneColor.stl

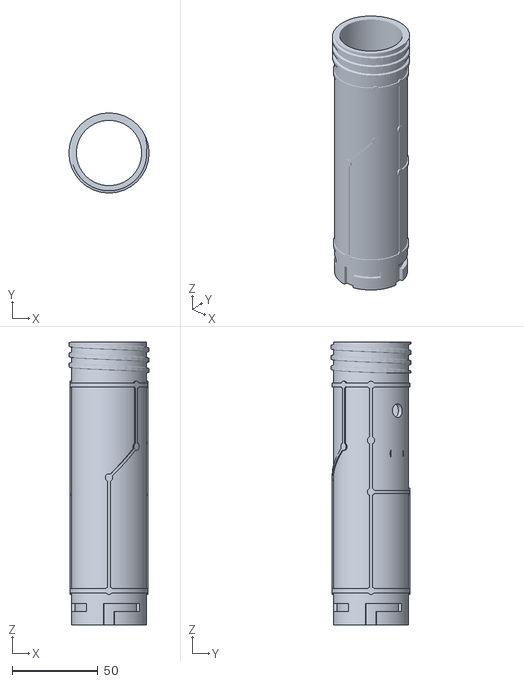
[picture p66: CAD file, 2026-08-04]
zettalights/Saber/Handle-oneColor.stl
46.8 x 46.8 x 165.0
