joshuawboone/barkitup/zettalights/Saber/Handle/handle-insert-2.stl

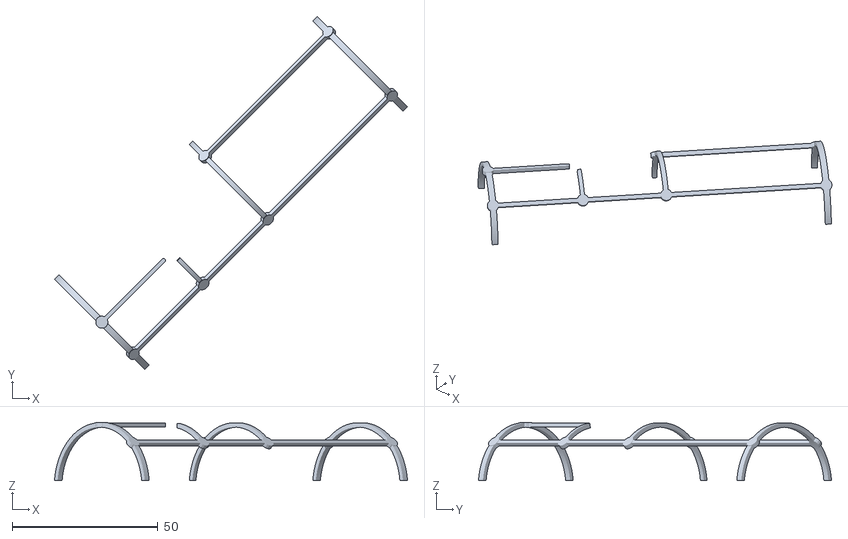
[picture p67: CAD file, 2026-06-17]
zettalights/Saber/Handle/handle-insert-2.stl
121.2 x 121.2 x 19.9
