joshuawboone/barkitup/zettalights/Saber/Hangers/saber_doubleHook.stl

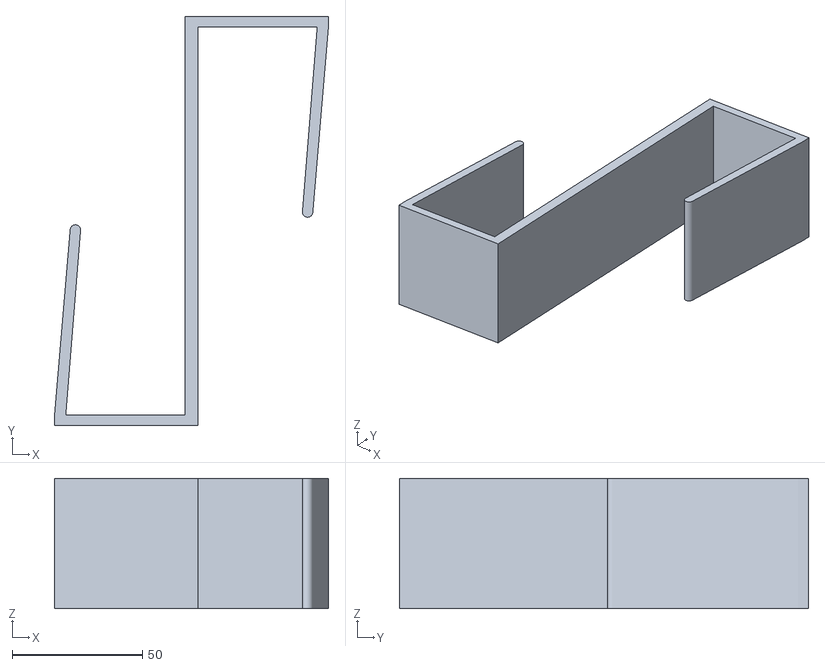
[picture p68: CAD file, 2026-06-17]
zettalights/Saber/Hangers/saber_doubleHook.stl
105.0 x 156.9 x 50.0
