joshuawboone/barkitup/zettalights/Staff/320/seg2.stl

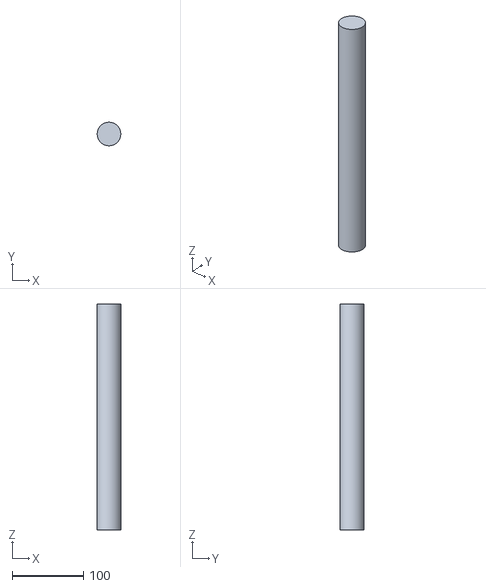
[picture p69: CAD file, 2026-08-04]
zettalights/Staff/320/seg2.stl
33.0 x 33.0 x 316.5
