joshuawboone/barkitup/zettalights/Staff/seg4.stl

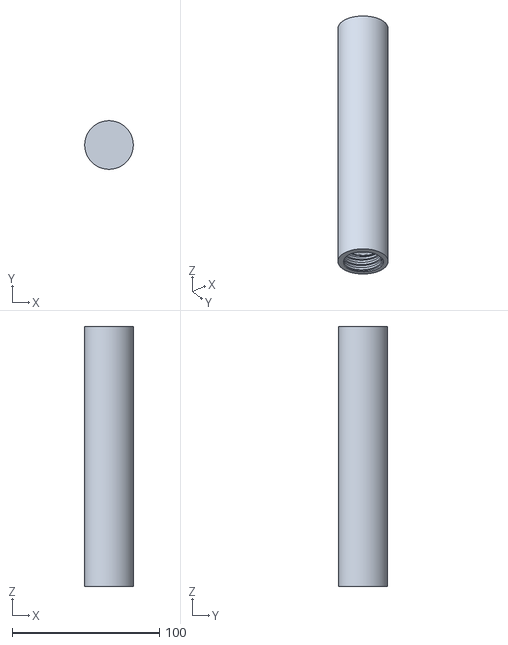
[picture p70: CAD file, 2026-07-16]
zettalights/Staff/seg4.stl
33.0 x 33.0 x 176.5
