joshuawboone/barkitup/zettalights/Saber/Handle-traces.stl

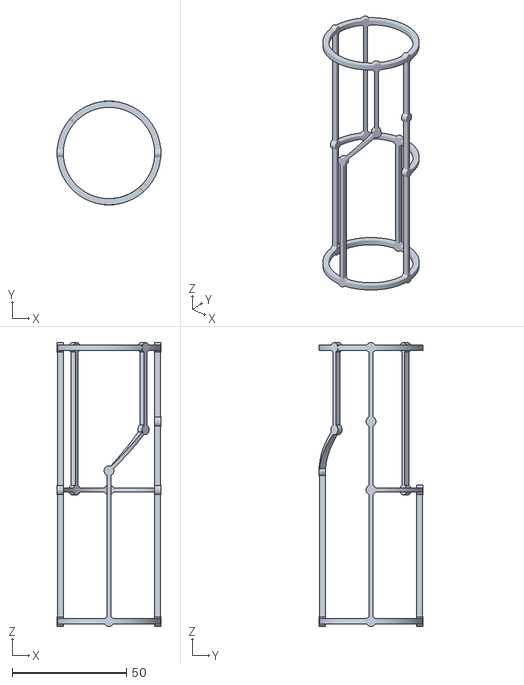
[picture p71: CAD file, 2026-08-04]
zettalights/Saber/Handle-traces.stl
45.4 x 45.4 x 124.4
