joshuawboone/barkitup/zettalights/Saber/Handle/handle-insert-1.stl

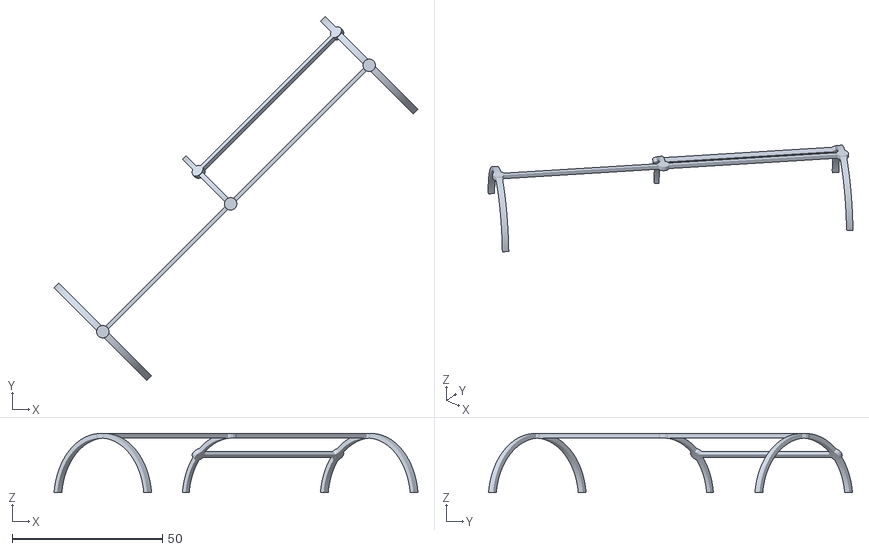
[picture p72: CAD file, 2026-06-17]
zettalights/Saber/Handle/handle-insert-1.stl
121.2 x 121.2 x 19.8
