joshuawboone/barkitup/zettalights/Staff/320/handle_tracesOnly.stl

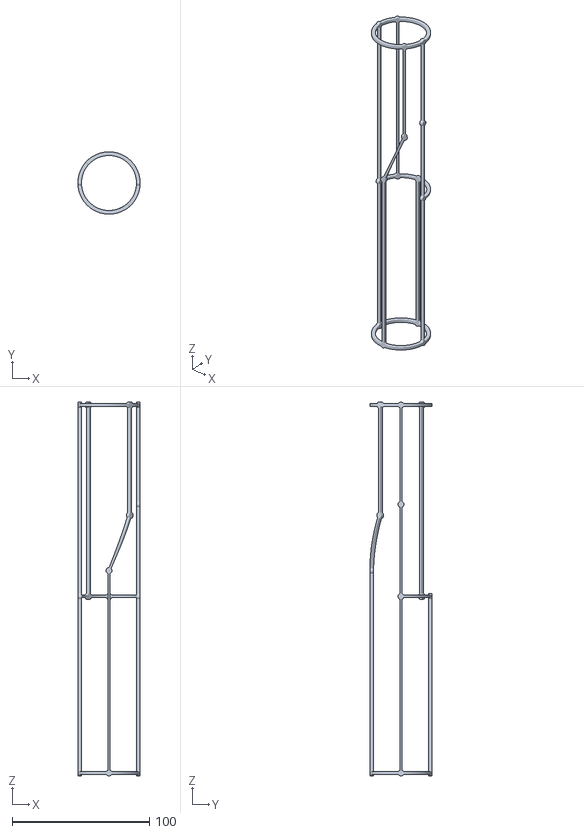
[picture p73: CAD file, 2026-08-04]
zettalights/Staff/320/handle_tracesOnly.stl
45.4 x 45.4 x 272.4
