joshuawboone/barkitup/zettalights/Staff/handle.stl

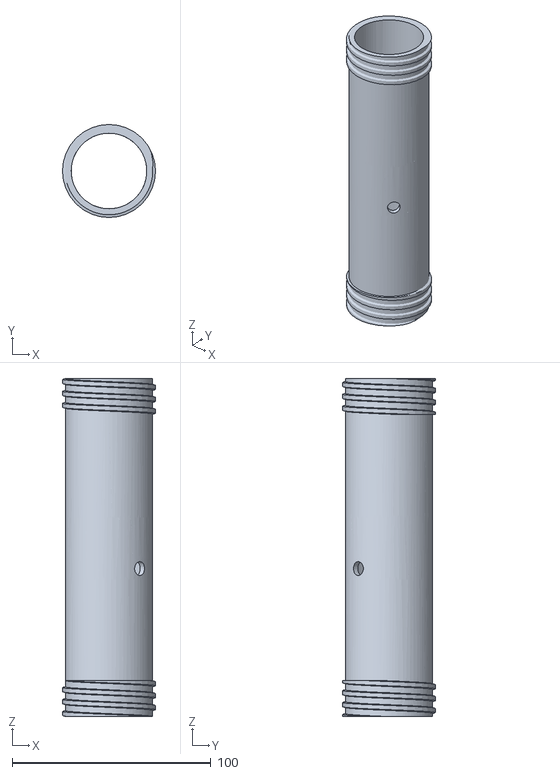
[picture p74: CAD file, 2026-07-16]
zettalights/Staff/handle.stl
46.8 x 46.8 x 170.0
