joshuawboone/barkitup/zettalights/Staff/320/handle_plain.stl

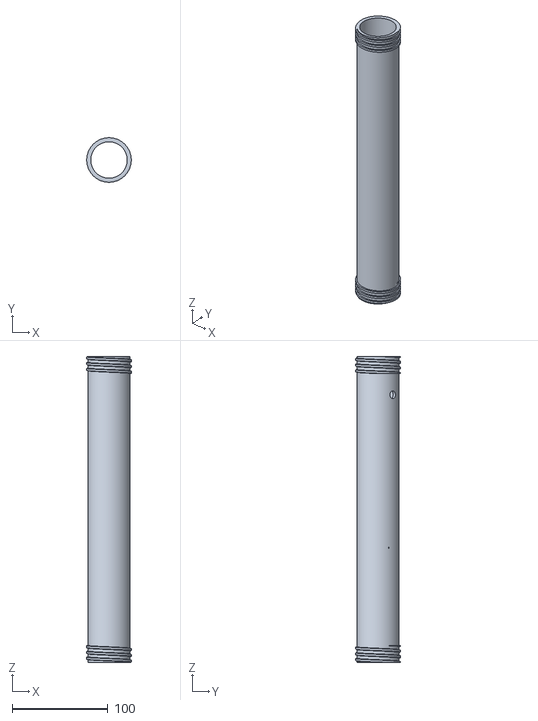
[picture p75: CAD file, 2026-08-04]
zettalights/Staff/320/handle_plain.stl
46.8 x 46.8 x 320.0
