joshuawboone/barkitup/zettalights/Staff/staff.3mf

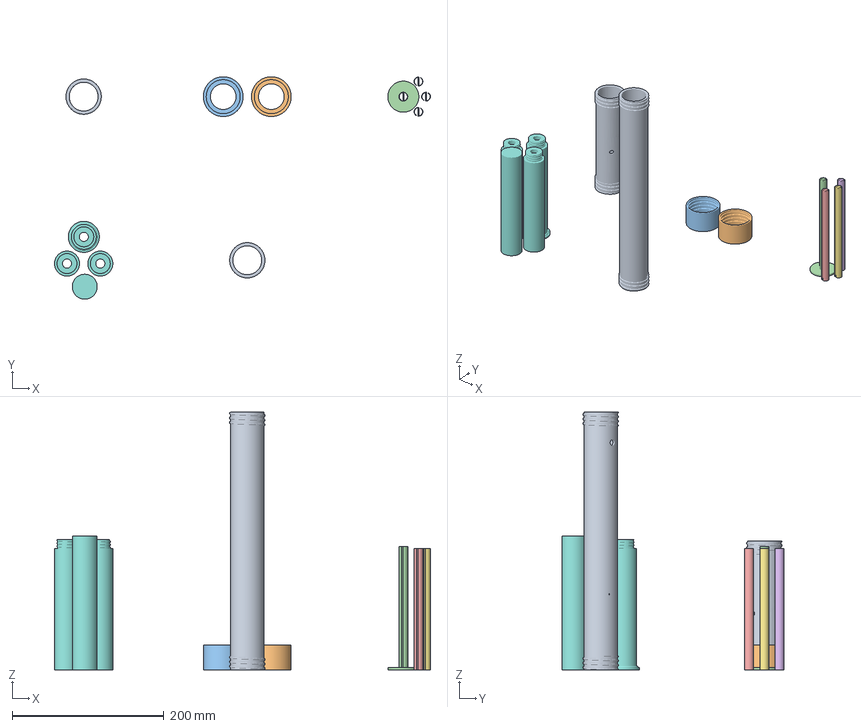
[picture p76: CAD file, 2026-07-16]
zettalights/Staff/staff.3mf
496.4 x 293.7 x 340.0 mm
Ingenious Bigery.stl
cap.stl x 2
LED-seg1.stl
LED-seg2-3-4.stl x 3
Assembly
handle340.stl
