joshuawboone/barkitup/(list of files, cad)

Other CAD files:
zettalights/Staff/320/cap.stl
zettalights/Staff/cap.stl
zettalights/Saber/Blade/blade mid.stl
zettalights/Staff/340/cap.stl
zettalights/Saber/Blade/blade-tip300.stl
zettalights/Saber/Cap-bladeSide.stl
zettalights/Staff/320/LED-seg1.stl
zettalights/Saber/Blade/blade-base300.stl
zettalights/Saber/Handle/closed cap.stl
zettalights/Staff/256/seg3.stl
zettalights/Staff/256/handle254.stl
zettalights/Staff/256/cap.stl
zettalights/Saber/Coupler-plain.stl
zettalights/Saber/Handle/handle-noTraces.stl
zettalights/Staff/320/LEDinsert1.stl
zettalights/Staff/320/handle320.stl
zettalights/Staff/ZL_Staff.scad
zettalights/archive/Saber/v2/Blade/blade mid.stl
zettalights/archive/Saber/v2/Blade/blade-base300.stl
zettalights/archive/Saber/v2/Blade/blade-tip300.stl
zettalights/archive/Saber/v2/Handle/closed cap.stl
zettalights/archive/Saber/v2/Handle/handle-noTraces.stl
zettalights/archive/Staff/v1/256/cap.stl
zettalights/archive/Staff/v1/256/handle254.stl
zettalights/archive/Staff/v1/256/seg3.stl
zettalights/archive/Staff/v1/320/LEDinsert1.stl
zettalights/archive/Staff/v1/320/cap.stl
zettalights/archive/Staff/v1/320/handle320.stl
zettalights/archive/Staff/v1/320/seg1.stl
zettalights/archive/Staff/v1/320/seg2.stl
zettalights/archive/Staff/v1/340/cap.stl
zettalights/archive/Staff/v1/cap.stl
