joshuawboone/barkitup/zettalights/Saber/ASSEMBLY.md

# ZL Saber - Assembly Guide
**Double-Blade Configuration** | V2.2

---

## Parts List

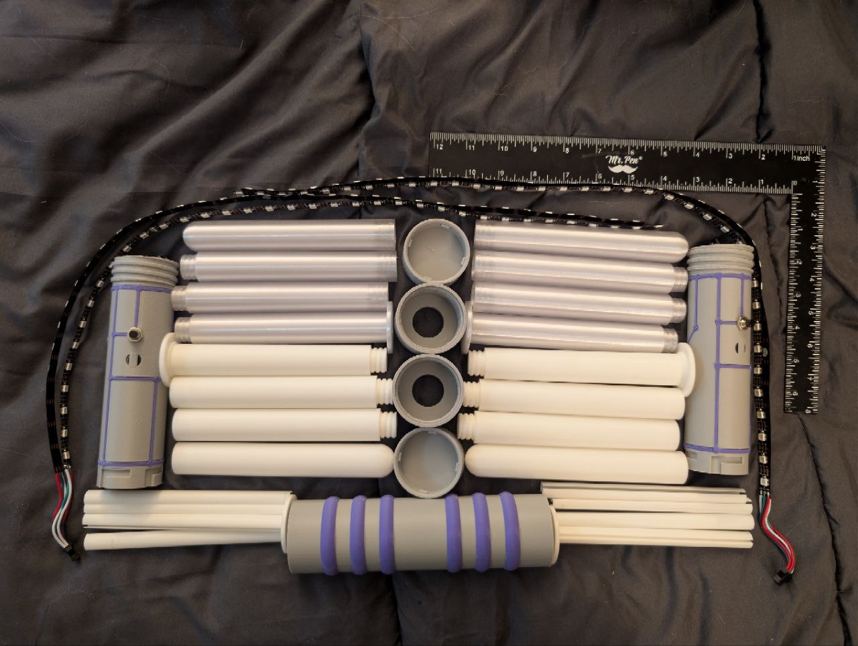
[picture p77: zettalights/Saber/photos/photo_1_2026-06-17_00-31-32.jpg]
All parts laid out


**Per blade (×2):**
- 1× Blade base segment (Tough+ white OR PETG clear)
- 2× Blade mid segments 
- 1× Blade tip segment
- 1× LED base insert (PLA white, has flange/disc at one end)
- 3× LED channel inserts (PLA white, grooved rod sections)
- 1× paired LED strip - 36 LEDs, 60/m WS2812B, pre-soldered JST connector

**Handle assembly (×2):**
- 1× Handle body (Tough+ grey, purple trace inserts installed)
- 1× Open cap (Tough+ grey) - threaded end
- 1× Closed cap (Tough+ grey) - alternate single-blade config only

**Coupler (×1):**
- 1× Coupler body (Tough+ grey, purple ring inserts installed)

> **Note:** The ruler in the parts photo is for scale - blade segments are ~150mm each, full assembled blade is ~600mm tip to base flange.

---

## Phase 1 - LED Insert Assembly

### Step 1 - Start with the LED base insert

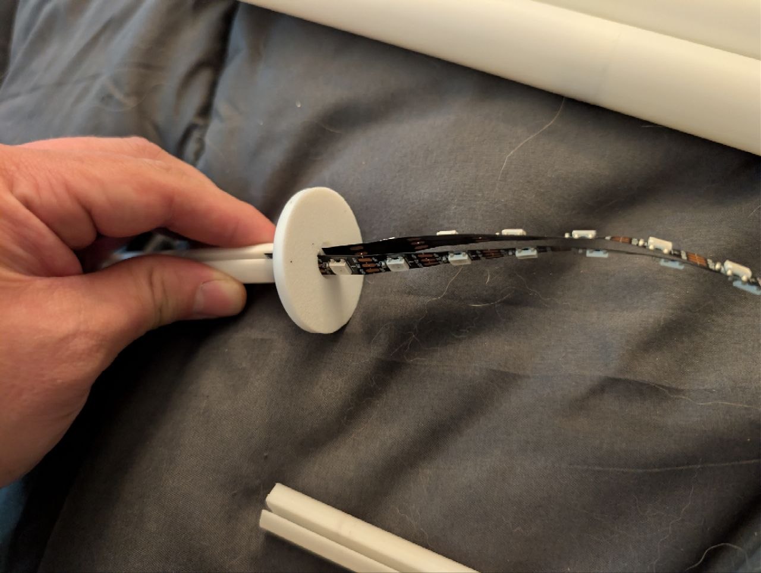
[picture p78: zettalights/Saber/photos/photo_29_2026-06-17_00-31-32.jpg]
LED base insert with strip


The LED base insert has a flat disc/flange at one end.  
Thread the LED strips back to back through the slots in the disc so the strips run along the flat inside of the insert rod facing outward.  
The JST connector should be on the disc/flange end - this will be the handle-side.

### Step 2 - Seat strip in channel groove

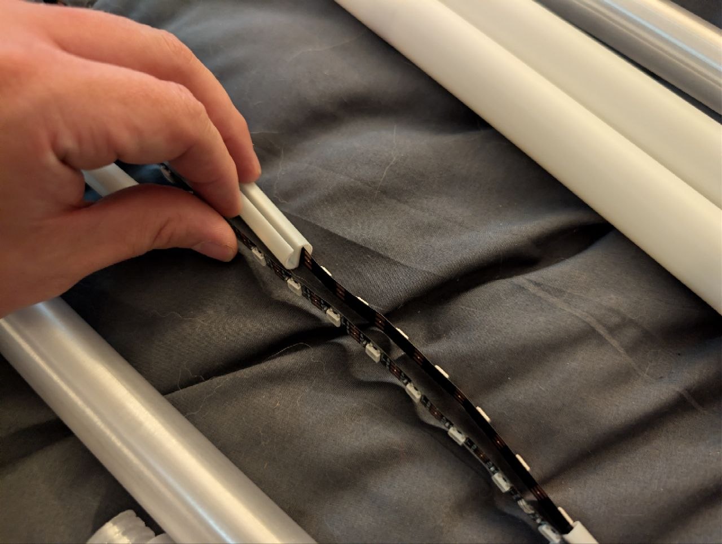
[picture p79: zettalights/Saber/photos/photo_21_2026-06-17_00-31-32.jpg]
Strip seated in channel


Each channel insert has a groove running its length on both sides.  
Lay the LED strips into this groove, LEDs facing outward.  
The strips should sit flush (mostly flush inside the S shaped inserts), no adhesive needed for assembly.  

The LED inserts are for alignment and keeping the strips from shorting on each other. 

### Step 3 - Stack all channel inserts

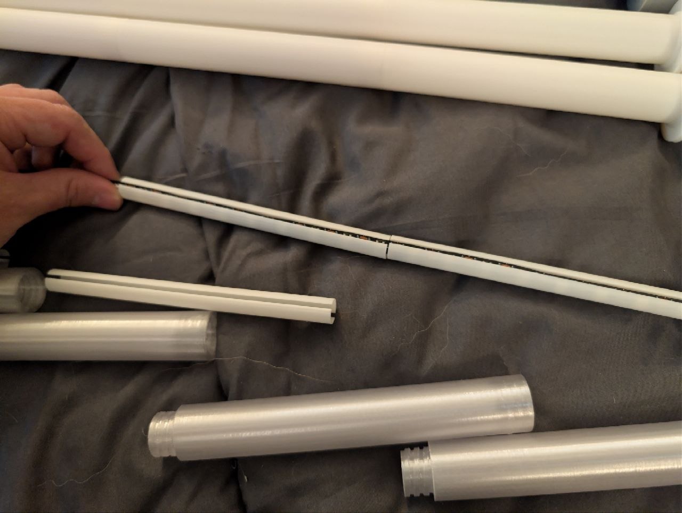
[picture p80: zettalights/Saber/photos/photo_23_2026-06-17_00-31-32.jpg]
Two inserts on strip


Continue adding the remaining 3 channel inserts end-to-end along the strip length.  
The inserts butt up against each other.  
Keep the LED faces all oriented the same direction (outward, toward the blade wall).

### Step 4 - Full LED rod assembly

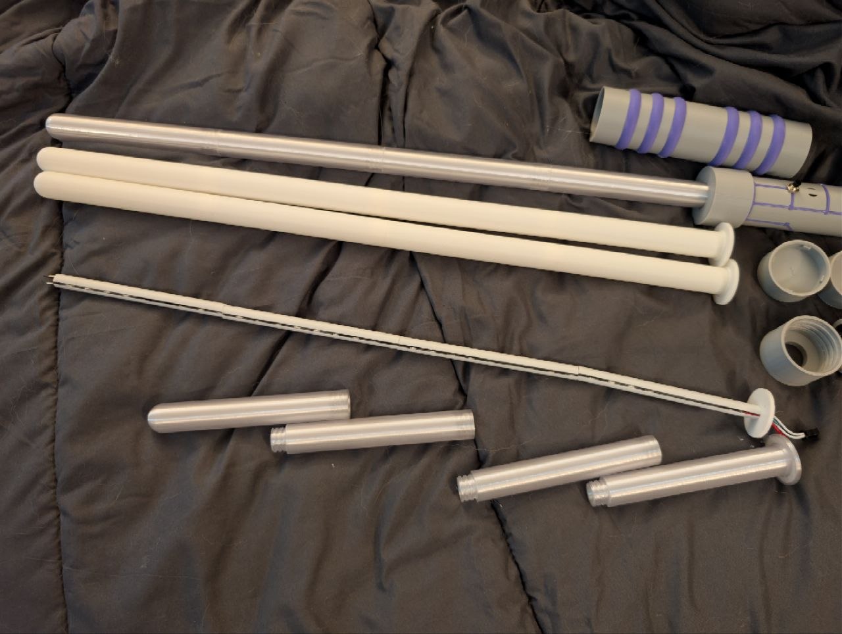
[picture p81: zettalights/Saber/photos/photo_19_2026-06-17_00-31-32.jpg]
Full LED rod alongside blade shells


You should now have a complete LED rod:  
base insert (with JST flange)  
3 channel inserts  
LED strips running the full length.  

Set carefully aside to assemble the blade proper.

---

## Phase 2 - Blade Shell Assembly

### Step 5 - Thread blade segments together

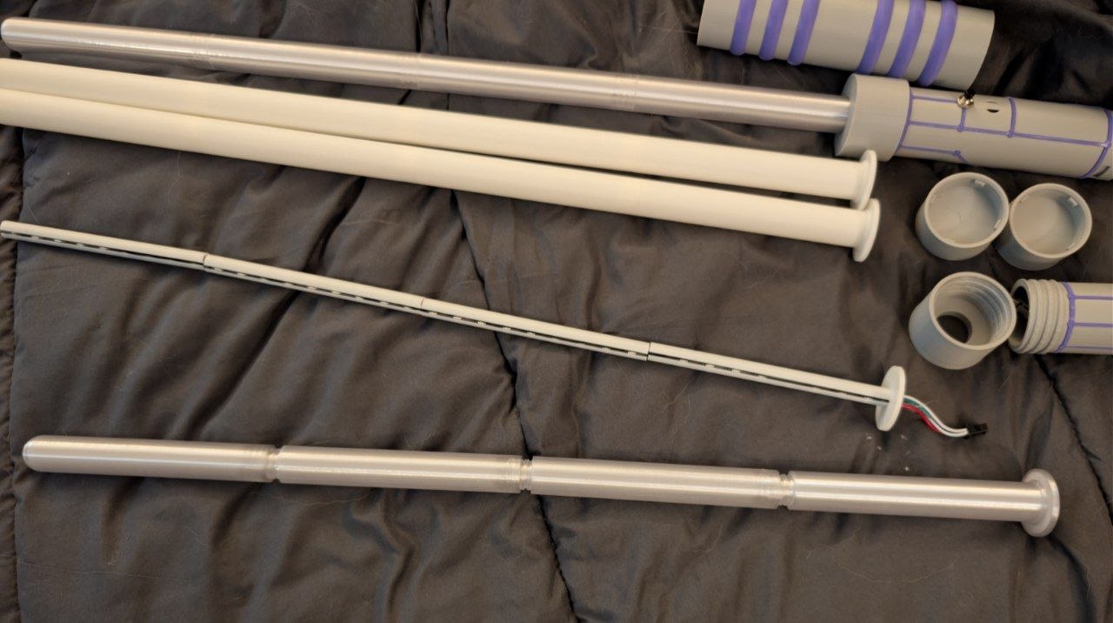
[picture p82: zettalights/Saber/photos/photo_15_2026-06-17_00-31-32.jpg]
Blade shells assembled


Screw the blade shell segments together:  
1. Blade base (has the flange base without inside threads)  
2. Blade mid × 2  
3. Blade tip  

Hand-tight is sufficient - these are threaded to snug up firmly without tools.  

### Step 6 - Insert LED rod into blade shell

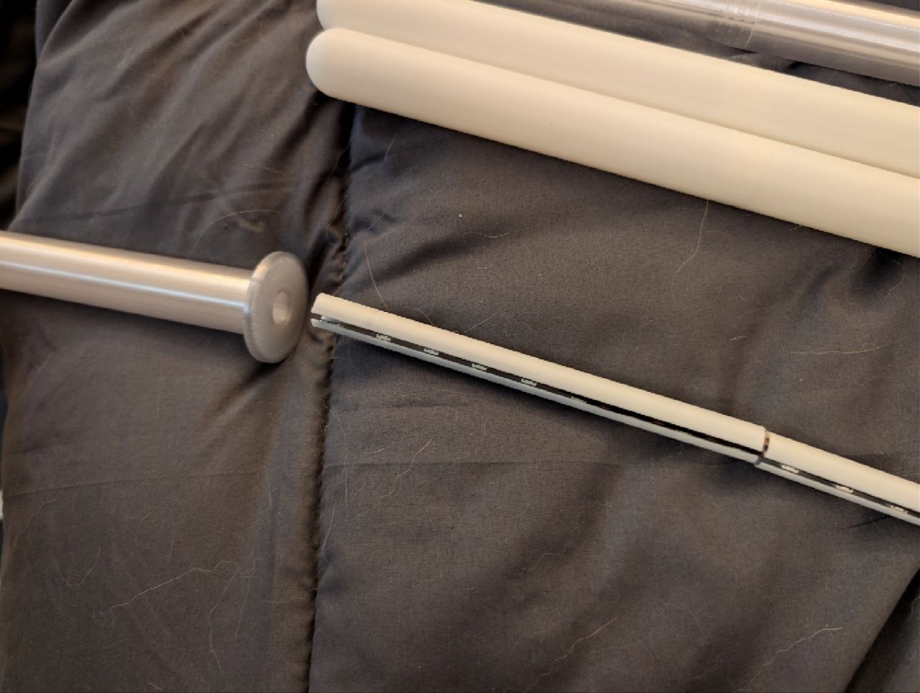
[picture p83: zettalights/Saber/photos/photo_13_2026-06-17_00-31-32.jpg]
Blade assembly with JST at base


Slide the LED rod assembly into the assembled blade shell from the base end.  
Feed it tip-first.  
The base insert flange will seat against the open end of the base segment.  
The JST connector trails out the bottom.

Once fully assembled the led strips can be pushed all the way in until they bottom out at the tip.  
The far end of the strips should sit roughly flush with the end of the insert channels. 
(Pull them out slightly so they are not in the way as the inserts are pushed in or exceed the length of the total inserts)  

They should stay where they are but you can also put a dab of hot glue at the base if you find them moving too much.

> The LED rod should fit snugly inside the 12mm ID bore. If it catches, check that the channel inserts are all aligned in the groove.

---

## Phase 3 - Handle Connection

### Step 7 - JST connectors

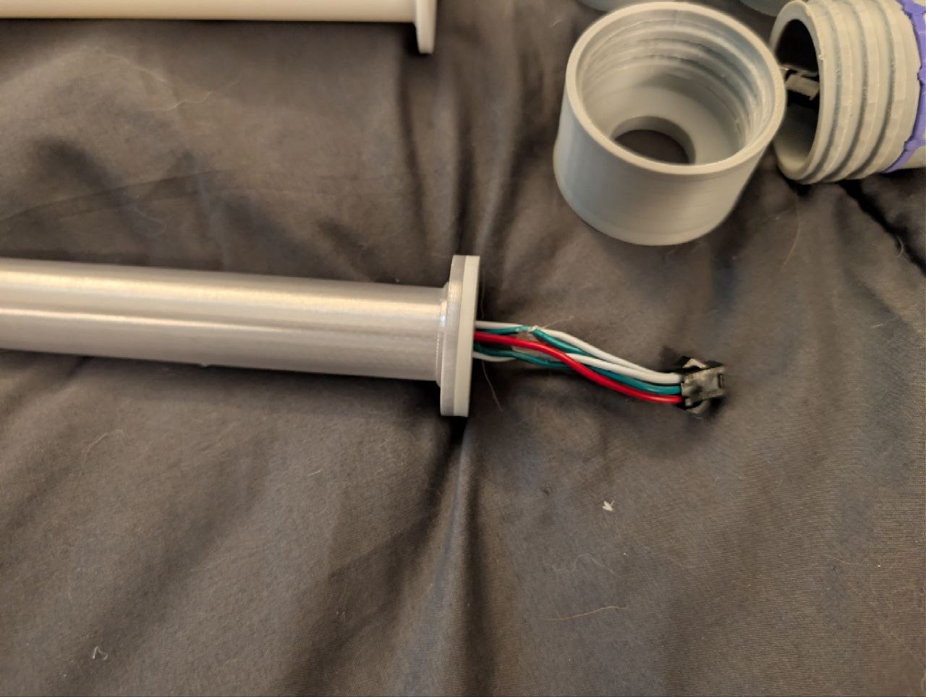
[picture p84: zettalights/Saber/photos/photo_7_2026-06-17_00-31-32.jpg]
JST connector at blade base


With the blade assembled, the JST connector (3-wire: red, white, green) extends from the base flange.  
This connects to the matching JST socket inside the handle.

### Step 8 - Connect blade to handle

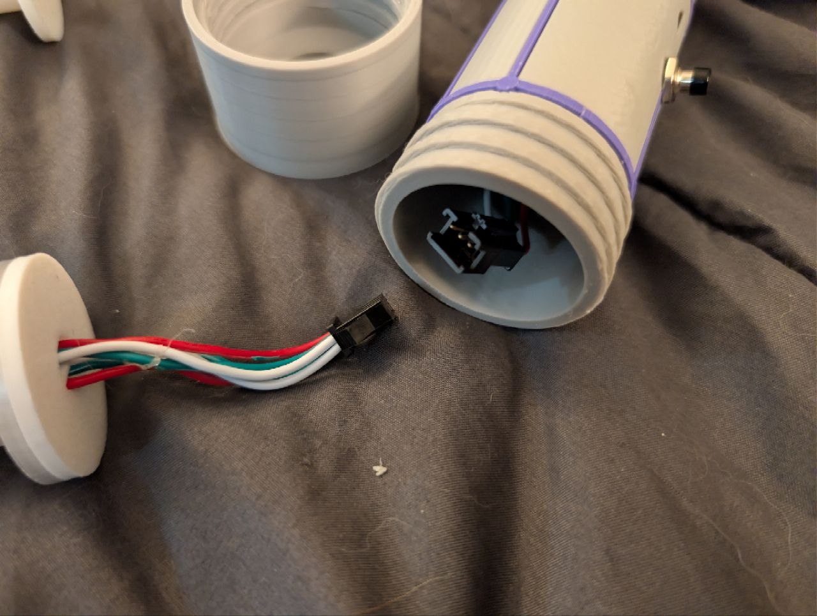
[picture p85: zettalights/Saber/photos/photo_6_2026-06-17_00-31-32.jpg]
JST being plugged in


Connect the blade assembly JST connector into the handle JST socket.  
The connector is keyed - it only goes in one way.  

> **Polarity note:** The JST connector is keyed but double-check that it seats fully before threading the blade on. It should click. 

### Step 9 - Power on test

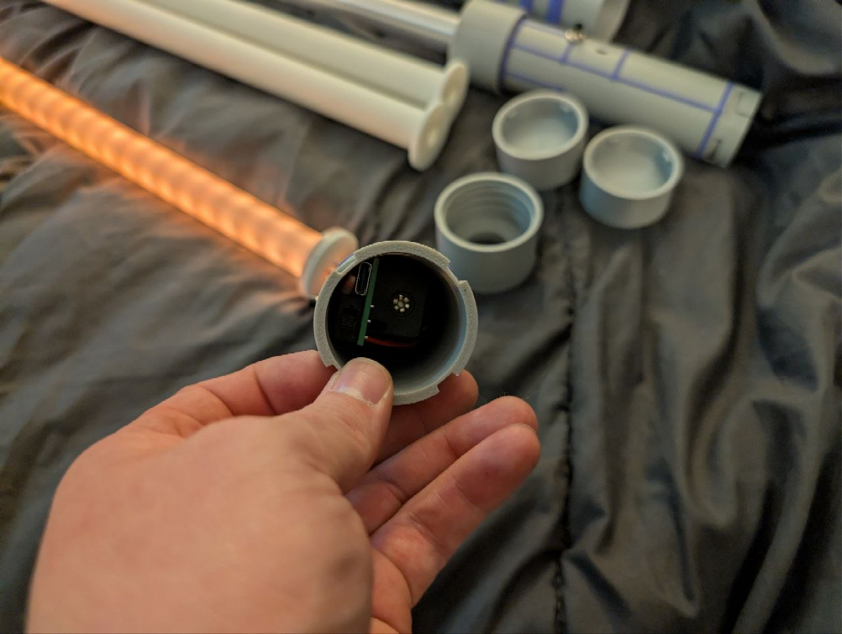
[picture p86: zettalights/Saber/photos/photo_4_2026-06-17_00-31-32.jpg]
First blade lit - single segment test

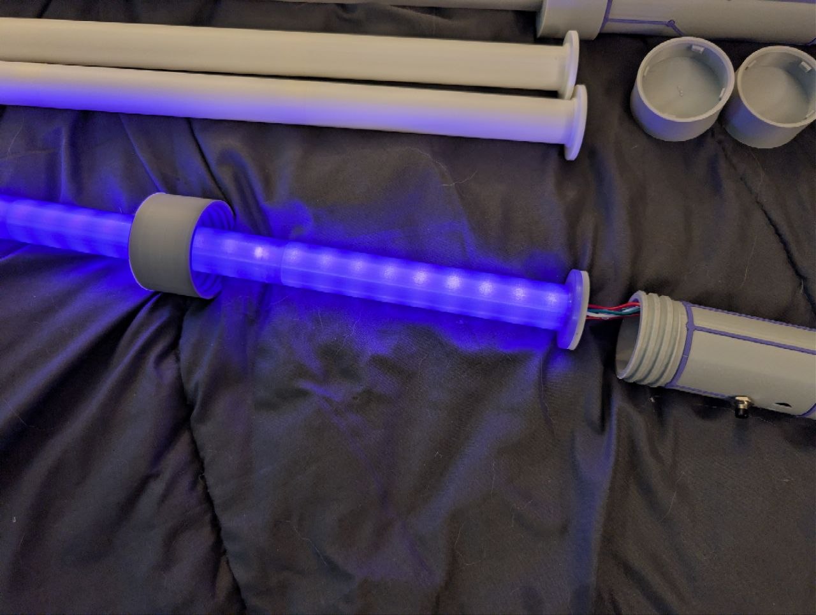
[picture p87: zettalights/Saber/photos/photo_3_2026-06-17_00-31-32.jpg]
Controller visible inside handle


Before finishing assembly, power on and verify the blade lights.  
The controller is seated inside the handle bore. (power switch at the bottom/pommel hole)  
You should see all LEDs respond in a power up sequence before entering the solid color fade mode. 

### Step 10 - Cap the handle

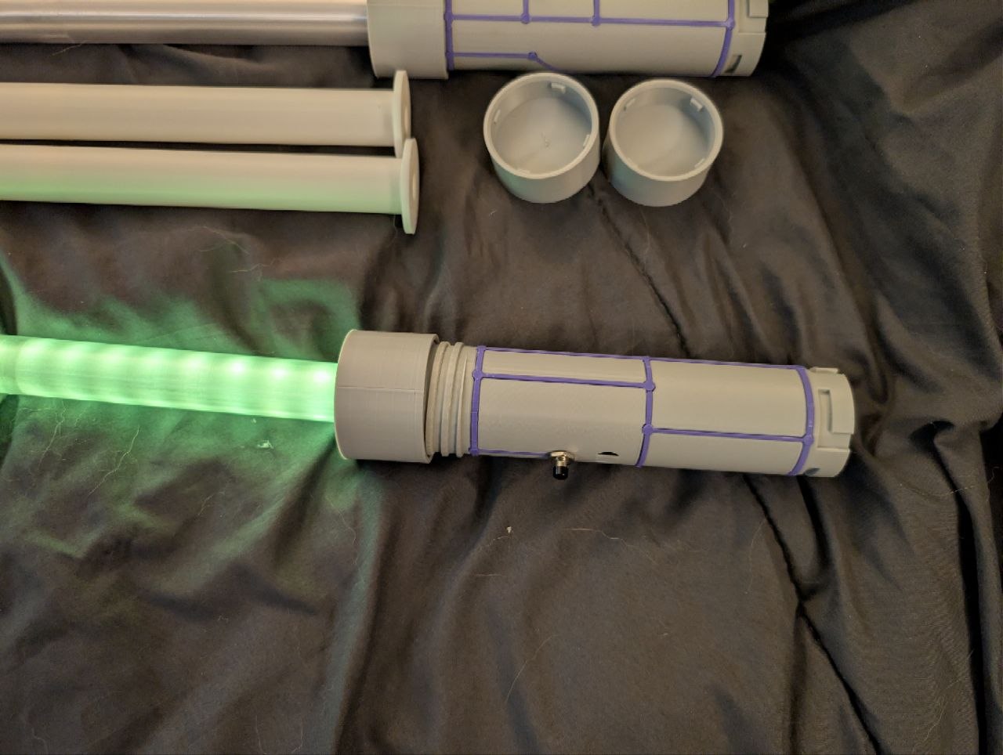
[picture p88: zettalights/Saber/photos/photo_2_2026-06-17_00-31-32.jpg]
Single blade final assembly lit


Once connected, thread the blade base segment onto the handle using the open cap.  
Hand-tight.  
The blade should not move freely. 

I found holding the blade with knees, holding handle still/steady in one hand and screwing the cap on is easiest.  
Keeping the blade and handle mostly stable while screwing will prevent the LEDs from twisting inside for the best visual apprearance.  

---

## Phase 4 - Double Blade Config

Repeat Phase 1–3 for the second blade. Use the coupler or the 2x closed caps as desired.

> **Double blade config:** Both blades buttons will line up if slotted slightly offset of eachother for the bayonet twist action. 

> **Single blade config:** Use a closed cap on the non-blade end of whichever handle you're using. Drop the coupler entirely.

---

## Notes

- **Blade orientation:** The LED strip groove faces toward the blade wall - LEDs point radially outward for best diffusion through the Tough+ shell.
- **Torque:** Hand-tight only on all threads. The Tough+ material has good thread strength but doesn't need tool torque.
- **Disassembly:** Reverse this guide. The blade unthreads from the handle, JST unplugs, LED rod slides out. No permanent connections.
- **Firmware:** Controller found in this repo as the hardware ZL_C-TH_v1 (can use whatever arduino compatibile you want) - code in Saber directory as .ino and .uf2 (64/255 brightness)

---

*ZL Saber V2.2 - Open Source
