joshuawboone/barkitup/zettalights/ZL_C-TH_v1/SCH_ZL_C-TH_v1-P_2025-09-09.pdf

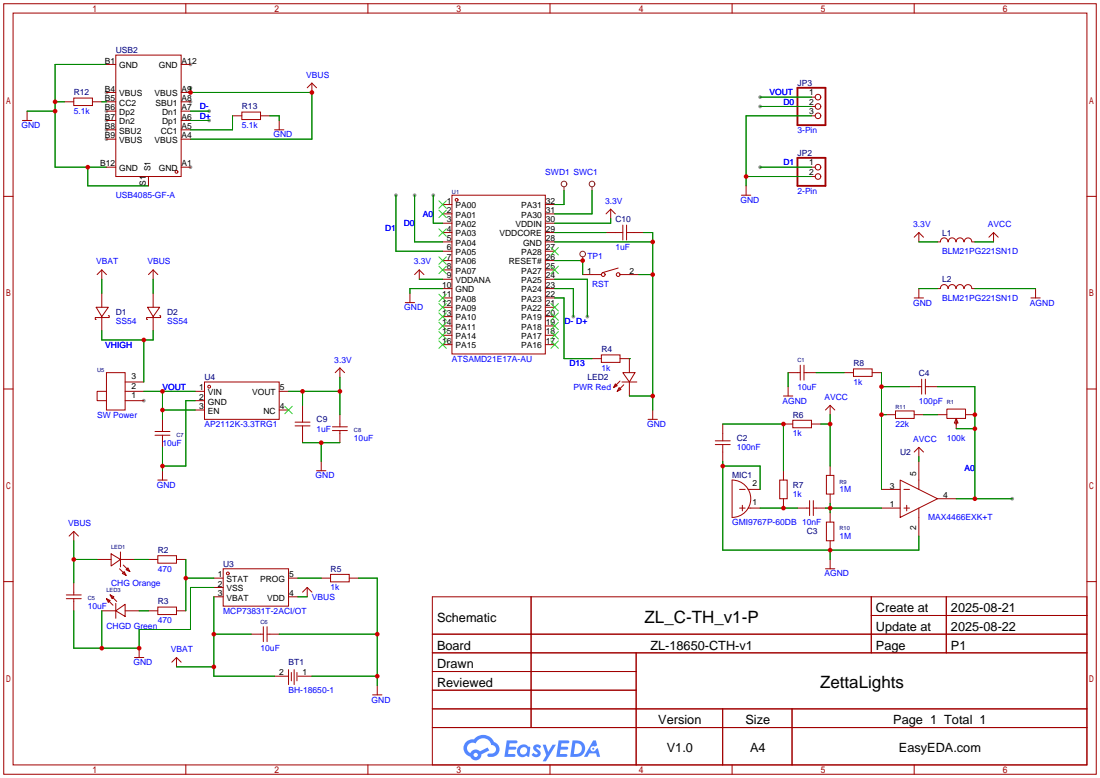
[picture p89: page 1]

Schematic | ZL_C-TH_v1-P | Create at | 2025-08-21

Update at | 2025-08-22

Drawn | ZettaLights
Reviewed

Version | Size | Page 1 Total 1
V1.0 | A4 | EasyEDA.com
