joshuawboone/barkitup/(list of files, drawings)

Other design files:
zettalights/ZL_C-TH_v1/ProDoc_Board_ZL_C-TH_v1.epro
zettalights/ZL_C-TH_v1/ProDoc_Schematic_ZL_C-TH_v1.epro
