joshuawboone/barkitup/(commit log)

2025-10-20 Update Zb_proto_56.txt
    typo. ARM > AVR
2025-12-05 Add files via upload
    Add ino as requested for PID codes.
2026-08-04 Update ZL_Saber.scad
    fix fem bore on blade seg
    [ZL_Saber.scad]
2026-08-04 Staff v1 archived and Saber v2 archived.Latest versions updated in main directories
    [320-Saber-Full-Project.3mf, 320-Staff-Full-Project.3mf, Cap-bladeSide.stl, Cap-pommelSide.stl, Coupler-oneColor.stl, Coupler-plain.stl, Coupler-rings.stl, Handle-oneColor.stl]
